Tsakiris98/Plug-Roll---Digital-Audio-Multi-Effect-Device/docs/input-section.md

# Input Section — Design Note (v0.5, 2026-11-12)

Status: **architecture and parts approved; schematic in progress** (drawn so
far: input jacks, INST/LINE relays, LINE receivers, INST buffer, gain stages
and ADC pad; the input section is complete except for the Daisy Seed socket). Every number marked
*(measure)* is provisional until it is measured on the real Daisy Seed Rev 5.

Changes from v0.4 (decision of 2026-11-12): **no digital control of analog
switching.** The INST/LINE toggle switches the relay coils directly; the
transistor driver and the three Daisy pins of this section (toggle, relays,
Right jack detection) are removed (sections 6 and 8).

Approved on 2026-11-12: output pad 5.6 kΩ / 1 kΩ; INST/LINE relays; analog pots on the control board with shielded analog cables; mono
normalling at the Right receiver input with the Neutrik NMJ6HCD2 jack.

Changes from v0.3: parts selected and checked at JLCPCB (section 10); SMD
wherever a part exists in SMD, including the relays; receiver built from one
0.1 % resistor value (gain exactly ×0.5); fixed gain ×11 with Basic resistor
values (was ×12 with an Extended 11 kΩ); numbers in sections 4 and 5
recalculated.

Changes from v0.2: relays are driven by the Daisy, the toggle goes only to a
GPIO, power-on default state added (section 6); jack contacts confirmed on the
Neutrik drawing (section 8); first-board acceptance measurements added
(section 11).

## 1. What the Daisy Seed Rev 5 gives us

| Item | Value | Source |
|---|---|---|
| Codec | WM8731 | Daisy Seed datasheet v1.0.5, schematic 4 of 4 |
| Audio pins used | 16 = Audio In L, 17 = Audio In R, 18 = Audio Out L, 19 = Audio Out R, 20 = AGND. The Seed's own codec is the only converter; nothing is added to it. | Daisy Seed datasheet v1.0.5, pin table |
| Circuit between the audio input pin and the codec | 0 Ω series, 2.2 µF coupling capacitor, nothing else (shunt capacitor not fitted) | same schematic (R24/C33, R26/C34) |
| ADC full scale | 1.0 Vrms × AVDD/3.3 (1.41 V peak at 3.3 V) | WM8731 datasheet, "Line Input to ADC" |
| Seed datasheet statement | "AC coupled and 3.6 Vpp, or approx. 1 Vrms" | Daisy Seed datasheet v1.0.5, p. 5 |
| Absolute maximum at the Seed audio input pins | −1.8 V … +1.8 V | Daisy Seed datasheet v1.0.5, Table 1 |
| Codec pin absolute maximum | AGND − 0.3 V … AVDD + 0.3 V | WM8731 datasheet, absolute maximum ratings |
| Codec input bias point | VMID = AVDD/2 = 1.65 V | WM8731 datasheet |
| Input resistance | 20 kΩ min, 30 kΩ typ (0 dB gain) | WM8731 datasheet |
| ADC SNR | 85 dB min, 90 dB typ, A-weighted, 48 kHz | WM8731 datasheet |

What this means:

- **The pins take a plain AC audio signal.** The coupling capacitor and the
  codec's bias are on the Seed. Our board adds no bias and no converter: the
  whole input section only brings each source to the right level for pins 16
  and 17, and the output section does the same from pins 18 and 19.
- **The Seed adds no protection of its own.** The pin goes through 0 Ω and a
  capacitor straight to the codec. Whatever limits the voltage and the current
  must be on our board.
- **Where ±1.8 V comes from.** The codec pin rests at 1.65 V. ±1.8 V around
  that is −0.15 V … +3.45 V, just inside the codec's own limit of −0.3 V …
  +3.6 V. The codec limit itself corresponds to ±1.95 V at the Seed pin.
- **The Seed datasheet contradicts itself.** 3.6 Vpp is 1.27 Vrms, not 1 Vrms.
  The codec datasheet says 1.0 Vrms, and "3.6 Vpp" looks like the ±1.8 V
  limit, not the full scale. This note assumes **0 dBFS = 1.0 Vrms = +2.2 dBu
  = 1.41 V peak** at the pin *(measure)*.
- **The limit is only 2.1 dB above full scale** (1.8 V against 1.41 V).

## 2. Block diagram

```
                      K1 (relay)
 L jack tip ─ RF ─────┬─ LINE ──────► LINE receiver L (balanced, −6.0 dB) ──┐
 L jack ring ─ RF ────│─────────────►                                       ├─ K2a ─► L chain
                      └─ INST ──────► INST buffer (1 MΩ, +12 dB) ───┬───────┘
                                      + diode clamp                 │
                                                                    │
 R jack tip ─ RF ───────────────────► LINE receiver R (balanced, −6.0 dB) ──┐
 R jack ring ─ RF ──────────────────►                               │       ├─ K2b ─► R chain
   (R jack empty: its switch contacts connect the R receiver        └───────┘
    inputs to the L receiver inputs)

 L chain / R chain (identical):

   ─► shielded cable ─► GAIN pot on the control board (one gang) ─► shielded cable ─►
      fixed gain +20.8 dB ──●── output pad −16.6 dB ── RC ──► Daisy ADC
                            │
                       "hot node" ──► bypass tap (to the output section)
```

- K1, K2a, K2b are relay contacts, switched together by the panel toggle (section 6).
  In INST, both chains take the INST buffer.
- "Hot node" = output of the last op-amp. 0 dBFS at the ADC corresponds to
  +18.9 dBu (9.6 V peak) there.

## 3. Output pad: keep the signal big, attenuate at the very end

**What it does.** The analog chain works at a high level (several volts). A
resistor divider ("pad") directly in front of the Daisy pin brings it down to
codec level. Values: **5.6 kΩ in series, 1 kΩ to ground**, with 2.2 nF C0G
across the 1 kΩ (low-pass at about 88 kHz against RF and out-of-band noise).

**Why.**
1. *Voltage limit by construction.* The op-amp output cannot go beyond its
   supply rails, so the pin cannot go beyond rail × divider ratio.
2. *Current limit by construction.* All current into the Seed passes through
   the 5.6 kΩ.
3. *Noise.* Op-amp noise is attenuated together with the signal.
4. *Bypass and output levels match.* 0 dBFS at the hot node is +18.9 dBu. The
   requirements ask for about +18 dBu maximum output. The output stage needs
   about +16.6 dB after the DAC anyway, and then the bypass signal taken at
   the hot node has the same level as the DAC path.

**Alternative and its cost.** Run the chain at codec level and clamp the pin
with Schottky diodes. Costs: diodes that protect at 1.8 V already conduct
below 1.41 V (distortion on peaks); BAT54S is an Extended part; the bypass
needs about 16 dB make-up gain; op-amp noise is not attenuated.

### 3.1 Check against the datasheets (your question)

What the NE5532 datasheet says about maximum output:

- The current TI datasheet (SLOS075K, December 2025) gives **no output swing
  figure at all**. Its revision history says the row "Maximum peak-to-peak
  output voltage swing" was removed.
- The previous revision (SLOS075J, 2015) gave 24 V min, 26 V typ peak-to-peak
  on ±15 V with a load of 600 Ω or more: the output stops 2 V (typical) to 3 V
  (worst case) short of each rail. That is a guarantee of how far the output
  *reaches*, not of where it *stops*.
- So the only upper limit a datasheet can prove is the supply rail itself.
  Recommended supply is ±5 V to ±15 V, so ±12 V is inside the specified range.

Divider ratio: unloaded 1/6.6 = 0.1515; with the codec's 30 kΩ typ 0.1473
(−16.6 dB); with its 20 kΩ min 0.1453. I assume the ±12 V rails stay within
±5 % (11.4 … 12.6 V). This becomes a requirement for the power supply.

| Op-amp output at | Hot node | Pin, Seed fitted (30 kΩ) | Pin, worst case (unloaded ratio) |
|---|---|---|---|
| Full scale, 0 dBFS | 9.6 V | 1.41 V | |
| Typical swing, nominal rail (12 V − 2 V) | 10.0 V | 1.47 V | 1.52 V |
| Typical swing, rail +5 % (12.6 V − 2 V) | 10.6 V | 1.56 V | 1.61 V |
| 1 V below a +5 % rail (more than the part can do) | 11.6 V | 1.71 V | 1.76 V |
| **Exactly on a +5 % rail (physically impossible)** | 12.6 V | **1.86 V** | **1.91 V** |

**Answer.** In every condition the op-amp can really reach, the pin stays at
or below 1.76 V, inside ±1.8 V. A proof that needs nothing but the datasheet
has to assume the output sits exactly on the rail, and then the pin could be
0.06 to 0.11 V over the Seed limit, still below the codec's own limit
(1.95 V). The real swing and the real pin voltage are measured on the first
board **before the Seed is plugged in** (section 11).

**Current limit.** Seen from the Seed pin, the pad is a voltage source of at
most 1.91 V behind 850 Ω (5.6 kΩ in parallel with 1 kΩ).

| Situation | Current into the Seed pin |
|---|---|
| Normal, full scale | 47 µA peak (1.41 V into 30 kΩ) |
| Pin tries to go over 1.8 V and the codec clamps it there | at most (1.91 − 1.8) V / 850 Ω = **0.13 mA** |
| Any fault at all (pin shorted, Seed unpowered while ±12 V is on) | at most 12.6 V / 5.6 kΩ = **2.3 mA** |

The WM8731 datasheet gives no rating for current forced into an input, so I
cannot quote a guaranteed safe value. Fractions of a milliamp through 5.6 kΩ
are far below what normally harms a CMOS input, and the 2.2 µF capacitor on
the Seed blocks any DC.

**The trade-off in the pad value.**

| Series resistor | Pin if the output were on a +5 % rail | Op-amp level needed for 0 dBFS | Consequence |
|---|---|---|---|
| 5.1 kΩ | 2.01 – 2.07 V | 8.9 V peak | ADC always reaches full scale; larger theoretical excess |
| **5.6 kΩ (chosen)** | 1.86 – 1.91 V | 9.6 V peak | full scale with a typical op-amp; a weak one clips about 0.5 dB earlier |
| 6.2 kΩ | 1.70 – 1.75 V | 10.5 V peak | provably inside ±1.8 V; the op-amp clips 0.4 – 1.9 dB before the ADC, so the last LEDs of the meter would never light |

**Approved: 5.6 kΩ / 1 kΩ.** It is one resistor per channel, so it can still
change to 5.1 kΩ or 6.2 kΩ if the measurements on the first board ask for it.

## 4. Gain staging

Reference: 0 dBFS = +2.2 dBu at the pin = +18.9 dBu at the hot node.
Target −18 dBFS = +0.9 dBu at the hot node.

| Stage | Gain | Resistors (provisional) |
|---|---|---|
| LINE receiver | −6.0 dB (×0.5) | differential amplifier, 10 kΩ inputs, 5 kΩ feedback made of two 10 kΩ in parallel (all 0.1 %) |
| INST buffer | +12 dB (×4) | non-inverting, 3 kΩ / 1 kΩ, 1 MΩ to ground at the input |
| GAIN pot | −∞ … 0 dB | 10 kΩ dual-gang audio taper, used as a divider |
| Fixed gain | +20.8 dB (×11) | non-inverting, 10 kΩ / 1 kΩ |
| Output pad | −16.6 dB | 5.6 kΩ / 1 kΩ (with the 30 kΩ of the codec) |

Total range, input jack to hot node: LINE −∞ … +14.8 dB, INST −∞ … +32.9 dB.

| Source | Input level | Total gain needed | Pot setting | ADC level | Notes |
|---|---|---|---|---|---|
| LINE, studio nominal | +4 dBu | −3.1 dB | −18.0 dB | −18 dBFS | around mid rotation of an audio-taper pot |
| LINE, hot peaks | +20 dBu | same | same | −2 dBFS | 2 dB spare without touching the knob |
| LINE, consumer | −10 dBV (−7.8 dBu) | +8.7 dB | −6.2 dB | −18 dBFS | |
| LINE, max before the receiver clips | about +24 dBu | | | | assumes ±9 V swing *(measure)* |
| INST, average guitar *(typical, measure)* | about −18 dBu | +18.9 dB | −14.0 dB | −18 dBFS | |
| INST, weak single coil *(typical)* | about −30 dBu | +30.9 dB | −2.0 dB | −18 dBFS | |
| INST, max before the buffer clips | about 2.3 V peak (+6 dBu) | | | | hot active pickups may exceed this |

Decisions:

- **LINE receiver attenuates by 6 dB.** A +20 dBu signal is 11 V peak, more
  than an op-amp on ±12 V can pass at unity gain. The receiver's resistors
  halve it before the op-amp sees it. Cost: 6 dB of gain made up later, which
  is harmless here (section 5).
- **Gain pot as a passive divider, followed by a fixed gain stage.** Simple,
  can always be turned down to silence, and almost no DC flows through the
  wiper. Alternative: pot in the feedback loop of an op-amp. Less noise at low
  gain, but it cannot go below unity, has an awkward control law, and a remote
  pot inside a feedback loop is asking for instability.
- **Resistor values follow what is Basic at JLCPCB.** ×11 uses 10 kΩ and
  1 kΩ, both Basic and already in the design; 11 kΩ (for ×12) is Extended.
  The receiver uses a single 0.1 % value (10 kΩ): two in parallel make the
  5 kΩ, so only one Extended resistor type is needed and the gain is exactly
  one half.
- **INST buffer has +12 dB.** A guitar is 15–20 dB quieter than line level.
  Gain in the first stage puts both modes in the same range of the knob. Cost:
  inputs above about 2.3 V peak clip in the buffer. Synths and keyboards on TS
  cables belong in LINE mode. If your guitars are hotter, this becomes +6 dB
  (one resistor).
- **Two 100 pF capacitors per gain stage, added when the schematic was
  drawn.** One across the 10 kΩ feedback resistor: it limits the bandwidth of
  the ×11 stage to about 160 kHz (−0.07 dB at 20 kHz), which keeps the stage
  stable and stops it amplifying radio frequencies. One from the wiper input
  to ground, next to the 100 kΩ: the wiper arrives through a cable, and this
  shorts any radio frequency the cable picks up (corner above 600 kHz with
  the 2.5 kΩ of the pot).
- **Known risk: pot rustle.** The NE5532 input draws a small DC current
  (200 nA typ, 800 nA max, TI SLOS075K) through the wiper. With some pots this
  is heard as a faint rustle while the knob is turned. It also gives a DC
  offset at the hot node that changes with the knob (at most about 22 mV from
  this current, plus the op-amp's own offset times 11). Checked on the
  prototype *(measure)*. Fallback without a board change: fit a TL072 in the
  U3 position (same SOIC-8 pinout, picoamp input current); the cost is more
  hiss at high gain, still below the codec floor.
- **The two gangs of an audio-taper pot do not track perfectly** (a few dB
  left/right error at low settings is normal for the part).

## 5. Noise estimate (20 Hz – 20 kHz, unweighted, calculated)

Op-amp data: NE5532 5 nV/√Hz and 0.7 pA/√Hz at 1 kHz (TI SLOS075K); TL072
15 nV/√Hz (value listed by JLCPCB for the ST part). Resistor thermal noise at
25 °C.

| Case | Noise at the hot node | Relative to full scale |
|---|---|---|
| LINE, pot at nominal (+4 dBu → −18 dBFS) | 15 µV (−94.4 dBu) | **−113 dBFS** |
| LINE, pot at maximum | 30 µV (−88.3 dBu) | **−107 dBFS** |
| INST, pot at "average guitar", input shorted | 24 µV (−90.0 dBu) | **−109 dBFS** |
| INST, pot at maximum (+32.9 dB), input shorted | 99 µV (−77.8 dBu) | **−97 dBFS** |
| Output pad resistors alone | 0.5 µV at the pin | −126 dBFS |
| **WM8731 ADC (datasheet, A-weighted)** | | **−90 dBFS typ, −85 dBFS min** |

Equivalent input noise: LINE receiver about −104 dBu, INST buffer about
−111 dBu (input shorted; a real pickup adds thermal noise of the same order).

**Conclusion.** In every setting the analog chain is 7 to 23 dB quieter than
the codec's typical figure. The noise floor of this device is the WM8731. The
only way to use it well is level: nominal −18 dBFS leaves about 70 dB between
the signal and the codec floor. A more expensive op-amp would change nothing
audible. Not included in the calculation: hum picked up by the pot cable
(section 7) and the real Rev 5 floor, which forum reports say is worse than
the datasheet. Both are measured.

## 6. INST/LINE switching (relays switched by the panel toggle)

**Contacts.** Three changeover contacts, switched together:

- K1: L jack tip goes to the LINE receiver (LINE) or to the INST buffer
  (INST). Without it, the 15 kΩ of the receiver would load the guitar and the
  1 MΩ input would be lost.
- K2a: the L chain takes the L receiver (LINE) or the INST buffer (INST).
- K2b: the R chain takes the R receiver (LINE) or the INST buffer (INST).
  **In INST the right channel always gets the left signal, whatever is plugged
  into the Right jack.**

Two 2-pole signal relays cover this, with one contact spare: **Omron
G6K-2F-Y-5V** (SMD, 10 × 6.5 mm, 5 V coil, 237 Ω, about 21 mA each). Contacts
are silver with gold cladding, rated down to 10 µA at 10 mV (Omron
datasheet), operate and release time 3 ms max. Gold-clad contacts are what a
small audio signal needs: plain silver contacts tarnish and need real current
to break through the film. The same relay is proposed for the bypass relay,
so one part number.

Relay pins, from the Omron G6K datasheet ("Terminal Arrangement/Internal
Connections", top view, G6K-2F-Y): 1 = coil +, 8 = coil −; moving contacts 3
and 6; released they rest on 2 and 7, energised they switch to 4 and 5. Coil
5 VDC: 21.1 mA, 237 Ω, must operate at 80 % of rated voltage or less, must
release at 10 % or more. The coil is polarised: pin 1 goes to +5 V.

| Contact | Moving (pin) | Released = LINE (pin) | Energised = INST (pin) |
|---|---|---|---|
| K1, first set | Left jack tip (3) | L receiver hot input (2) | INST buffer input (4) |
| K1, second set | not used (6) | (7) | (5) |
| K2, first set | L chain input (3) | L receiver output (2) | INST buffer output (4) |
| K2, second set | R chain input (6) | R receiver output (7) | INST buffer output (5) |

A 100 nF capacitor sits on the 5 V rail at the relays.

One caution: at K1 the guitar signal flows into 1 MΩ, which is well below
10 µA. Gold contacts normally handle this, but it is outside the datasheet
figure, so it is on the list of things to listen for on the prototype.

**Control.**

- The panel toggle switches the two relay coils directly. Coil + (pin 1) is
  on the 5 V rail of the main board. Coil − (pin 8) of both relays is the line
  `INST_SW`, which goes through the ribbon to the toggle on the control
  board; the toggle closes it to ground. **Open = LINE, closed = INST.**
- A 1N4148W diode across the coils absorbs the voltage spike when the toggle
  opens. A 100 nF capacitor sits on the 5 V rail at the relays.
- The ribbon wire carries about 42 mA DC in INST mode and nothing in LINE.
  It is a steady current, so it does not disturb the control voltages next
  to it; it only steps when the toggle is moved.
- **No Daisy pin, no firmware.** The Daisy does not know the mode and does
  not need to: in INST the right chain already gets the left signal through
  K2, in the analog path.
- Why relays at all, when a toggle could switch the signal itself: the toggle
  is on the control board. Switching the audio there would send the
  high-impedance guitar signal through a cable to the panel and back, which
  picks up hum and loses treble. The relays keep the signal at the jacks and
  only the coil current travels.

**Power-on.** The relays follow the toggle as soon as 5 V is present. The
outputs are muted during power-up and power-down (output section), so this is
not heard. With the control board unplugged the relays stay released = LINE,
the safe state (LINE accepts up to about +24 dBu).

**Click without a firmware mute.** Until v0.4 the Daisy drove the relays, so
the firmware could mute, switch and unmute. Without that, a click would come
from the two sources of a relay contact (LINE receiver and INST buffer
outputs) sitting at slightly different DC voltages, a step that the ×11 stage
amplifies. Therefore each of the three sources reaches K2 through a coupling
capacitor (10 µF, 50 V) with 100 kΩ to ground on the relay side: both sides
of every contact rest at 0 V. This also takes the sources' DC offset off the
gain pot. Low corner with the 10 kΩ pot: 1.6 Hz (3.2 Hz in INST, where one
capacitor feeds both pot sections). Residual click measured on the prototype
(section 11.2); the fallback is the transistor driver with a firmware mute.

GPIOs used by the input section: **none.**

## 7. Analog pots on the control board (decided)

All pots stay on the control board. The pre-amp gain pot gets a **dedicated
short shielded analog connection**, separate from the digital ribbon. The same
rule applies to master volume and HP volume (output section).

What matters for the gain pot, and why:

- **Its ground is the main board's analog ground, brought over in the same
  cable.** The bottom end of the pot is the reference of the following ×11
  stage. If it were tied to the control board's ground, every millivolt of LED
  and scanning current noise between the two boards would be amplified 11
  times. The pot must not touch the control board ground at all.
- **Input and output pots do not share a cable.** The wiper of the gain pot
  is a sensitive point followed by ×11. If it ran next to the master volume
  wires (the output of the same device), the output would leak back into the
  input: a feedback path around the whole effect chain. So: one shielded cable
  for the gain pot, a separate one for master + HP volume, connectors apart.
- **Each wiper wire is shielded**, shield connected at the main board only.
  The wiper is the only point in the chain with a few kΩ of impedance
  (2.5 kΩ at worst); everything else is driven by op-amp outputs.
- **A 100 kΩ resistor from the wiper input to ground on the main board**, so
  the stage stays quiet if the cable is unplugged.
- **Connection (approved):** these are *internal* connectors between the two
  boards, not panel jacks. One 3.5 mm stereo jack per
  channel on each board (SMD, PJ-327A) and a ready-made shielded 3.5 mm
  stereo cable between them, 15–20 cm. Tip = top of the pot, ring = wiper,
  sleeve = analog ground and shield. Why: these cables are shielded, cheap,
  available in any length, and need no crimping tool. One cable per channel
  also keeps left and right apart. Alternative: JST-type headers with a
  hand-made shielded cable; smaller, but you would have to crimp the contacts
  and prepare the shield yourself.
- **PJ-327A 5JJ pins, from the SHOU HAN drawing (2020.6.24):** pins 1 and 2 =
  sleeve, pin 3 = ring, pin 4 = tip, pin 5 = switch contact that rests on the
  tip while no plug is inserted. Use: pin 4 = top of the pot, pin 3 = wiper,
  pins 1 and 2 = analog ground. **Pin 5 stays unconnected**: grounding it
  would short the driving op-amp whenever the cable is unplugged.
- 100 Ω in series with the "top" line on the main board. It keeps the cable
  capacitance away from the op-amp output and limits the current when a plug
  is pushed in (its tip slides over the other contacts on the way).

Everything that is not audio goes in the general ribbon cable: LEDs, buttons,
encoder, INST/LINE toggle, and the 40 control pots with their multiplexers
(they only carry a control voltage that the Daisy reads). Master and HP
volume carry audio like the gain pot, so they stay out of the general ribbon;
their cable is decided in the output section.

Cost of this decision against a pot on the main board: one more cable and two
connectors, and some risk of hum pickup that only the prototype can quantify.

## 8. Mono normalling and jack (approved)

**Jack.** Neutrik NMJ6HCD2, 6.35 mm TRS, horizontal PCB mount, through-hole.
LCSC **C368502**, 772 in stock on 2026-11-12. Used for both inputs
(hand-soldered).

**Two separate jacks, one per channel: Left and Right.** Neutrik calls the
part "stereo" only because it has three conductors. Here each jack carries
one balanced mono channel: tip = hot (+), ring = cold (−), sleeve = ground.
A TS plug also works (the ring is then grounded by the plug).

**Contact arrangement, confirmed from Neutrik.**

- Drawing ST-NMJ6HCD2 (released 26.02.2021): six PCB pins in two rows
  16.23 mm apart. One row is **T, R, S**, the other **TN, RN, SN**, at 16.7,
  10.35 and 4 mm from the panel face. Hole diameter 1.4 mm, panel cut-out
  11.4 mm.
- Neutrik "Jacks – Circuits" list: type N\*J6\*\* is "3x switching
  (normalling) Stereo". Each of TN, RN, SN rests on its own T, R, S spring
  while the jack is empty and opens when a plug is inserted.
- Switch contact rating: 0.5 A at 50 V (Neutrik product page). Far above what
  a line signal or a logic input needs.

These are *normalling* contacts, not an isolated switch: a contact can only
feed something into the jack's own terminals, that is, into the input of the
Right receiver. That is why the normalling is done at the receiver input.

**Implementation.**

- R jack **TN** → L receiver hot input (taken after K1); R jack **RN** → L
  receiver cold input. With the Right jack empty, both receivers listen to the
  Left jack. The right channel then carries the left signal for the DSP and
  for the analog bypass, at the same level.
- L jack TN and RN → ground, so an empty Left input is silent.
- SN of both jacks is not used. The Daisy needs no mono detection: the
  normalling already puts the left signal on both channels.
- No relay, no extra parts. The source sees two receivers in parallel (about
  10 kΩ balanced), which any line output drives without effort.
- In INST the normalling does not matter: K2b gives the right chain the INST
  buffer. Because the R jack's TN is wired after K1, the Right receiver does
  not load the guitar either.

## 9. Input protection

- **LINE inputs.** The receiver's own 10 kΩ input resistors limit the current.
  A BAV99 at each op-amp input steers anything beyond the ±12 V rails into the
  supply. DC-blocking capacitors in front (10 µF, 50 V, 1.6 Hz corner) stop
  DC from a faulty source. 100 pF C0G from each leg to ground at the jack
  shorts radio frequencies.
- **DC-blocking capacitor type.** 10 µF / 50 V ceramic (X5R, 1206, Basic).
  This kind of ceramic changes its capacitance a little with the voltage
  across it, which can distort. Here it does not matter, because almost no
  signal voltage appears across a capacitor this large: about 5 % of the
  signal at 20 Hz, falling quickly above that. The large value is also what
  keeps the hum rejection good at 50 Hz (the two capacitors of a receiver are
  not identical). Alternative: bipolar electrolytic capacitors, the classic
  audio choice, but through-hole and hand-soldered. Low-frequency distortion
  is checked on the prototype *(measure)*. 1206 is an exception to the 0603
  rule: 10 µF at 50 V does not exist in 0603.
- **INST input.** 1 kΩ series resistor, 100 pF to ground, 100 nF (X7R, 50 V)
  blocking capacitor into 1 MΩ (1.6 Hz corner), BAV99 to the rails directly at
  the op-amp input. The clamp sits after the capacitor on purpose: a voltage
  step at the jack passes through the capacitor unchanged, so a clamp in front
  of it would not protect the op-amp input. The capacitor itself is rated
  50 V. Cost: the leakage current of the diodes flows through the 1 MΩ and
  adds a small DC offset at the buffer output *(measure)*. The 1 kΩ is a
  compromise: larger protects better but adds hiss (1 kΩ adds 4 nV/√Hz against
  the 15 nV/√Hz of the op-amp).
- **Daisy pin.** Protected by the pad (section 3). No diodes.
- **Receiver precision.** A balanced receiver rejects hum only as well as its
  resistors match: about 30 dB with 1 % parts, about 50 dB with 0.1 %. All
  receiver resistors are 10 kΩ 0.1 % thin film (six per receiver, twelve in
  total). Extended part, justified: hum rejection depends on it.

## 10. Parts

Basic/Extended status and stock read from jlcpcb.com on 2026-11-12. Every part
below has a symbol, footprint and 3D model in the LCSC/EasyEDA library
(checked with easyeda2kicad). **Rule: SMD wherever the part exists in SMD;**
through-hole only for the panel jacks.

### 10.1 Placed by JLCPCB (SMD)

| Function | Part | Package | LCSC | Library | JLCPCB stock | Qty |
|---|---|---|---|---|---|---|
| Op-amp: receivers, gain stages | NE5532DR, TI | SOIC-8 | C7426 | Basic | 265,940 | 2 |
| Op-amp: INST buffer | TL072CDT, ST | SO-8 | C6961 | Basic | 123,888 | 1 |
| Clamp diodes | BAV99,215, Nexperia | SOT-23 | C2500 | Basic | 1,914,133 | 5 |
| INST/LINE relays | G6K-2F-Y-5V, Omron | SMD 10 × 6.5 mm | C2982926 | **Extended** | 29,764 | 2 |
| Relay coil diode | 1N4148W | SOD-123 | C81598 | Basic | 3,368,367 | 1 |
| Receiver resistors 10 kΩ 0.1 % thin film | RT0603BRD0710KL, Yageo | 0603 | C95204 | **Extended** | 1,769,696 | 12 |
| Resistor 100 Ω 1 % | 0603WAF1000T5E | 0603 | C22775 | Basic | 9,914,941 | |
| Resistor 1 kΩ 1 % | 0603WAF1001T5E | 0603 | C21190 | Basic | 28,867,822 | |
| Resistor 3 kΩ 1 % | 0603WAF3001T5E | 0603 | C4211 | Basic | 6,321,740 | |
| Resistor 5.6 kΩ 1 % (pad) | 0603WAF5601T5E | 0603 | C23189 | Basic | 666,557 | 2 |
| Resistor 10 kΩ 1 % | 0603WAF1002T5E | 0603 | C25804 | Basic | 42,786,584 | |
| Resistor 100 kΩ 1 % | 0603WAF1003T5E | 0603 | C25803 | Basic | 15,036,949 | |
| Resistor 1 MΩ 1 % | 0603WAF1004T5E | 0603 | C22935 | Basic | 3,882,525 | |
| Capacitor 100 pF C0G 50 V (RF, feedback) | CL10C101JB8NNNC, Samsung | 0603 | C14858 | Basic | 3,542,892 | |
| Capacitor 2.2 nF C0G 50 V (pad filter) | 0603CG222J500NT, FH | 0603 | C2991172 | **Extended** | 68,303 | 2 |
| Capacitor 100 nF X7R 50 V (decoupling, INST coupling) | CC0603KRX7R9BB104, Yageo | 0603 | C14663 | Basic | 36,013,175 | |
| Capacitor 10 µF X5R 50 V (LINE DC blocking, supply bulk) | CL31A106KBHNNNE, Samsung | 1206 | C13585 | Basic | 3,429,083 | |
| Gain pot cable jack 3.5 mm stereo | PJ-327A 5JJ, SHOU HAN | SMD | C668605 | **Extended** | 10,744 | 2 |

Quantities without a number are fixed when the schematic is drawn.

Four Extended part types in this section (relay, 0.1 % resistor, C0G 2.2 nF,
3.5 mm jack). Each has a one-time fee of about 3 USD per order at JLCPCB. All
four are there for a reason that affects the audio or has no Basic
equivalent:

- 2.2 nF **C0G** at the ADC pin: the Basic 2.2 nF is X7R, a ceramic that
  distorts when the full signal sits across it. C0G does not.
- Relay and 3.5 mm jack: no Basic part of this kind exists.

### 10.2 Hand-soldered (through-hole)

| Function | Part | LCSC | Stock (LCSC) | Qty |
|---|---|---|---|---|
| Input jacks L and R | NMJ6HCD2, Neutrik | C368502 | 772 | 2 |

### 10.3 Alternatives for critical parts

| Part | Alternative | LCSC | Library | JLCPCB stock | Note |
|---|---|---|---|---|---|
| G6K-2F-Y-5V | HFD4/5-SR, Hongfa | C64399 | Extended | 29,205 | same body size and coil voltage, 28 mA coil; its own footprint, not drop-in |
| TL072CDT | TL072CDR, TI | C67473 | Extended | 49,480 | same pinout |
| NE5532DR | NE5532DTR, XBLW | C18723604 | Extended | 1,109 | weak alternative (low stock); the TI part has 265,940 in stock |
| 2.2 nF C0G | GRM1885C1H222JA01D, Murata | C77033 | Extended | 44,811 | same value and size |

### 10.4 Why two op-amp types

The NE5532 has bipolar inputs that draw 200 nA typ, 800 nA max (TI
SLOS075K). Through the 1 MΩ a guitar input needs, that is 0.2 to 0.8 V of DC
offset, and its current noise through a high-impedance pickup would hiss. The
TL072 draws picoamps, so it is the right part for the one high-impedance
node. Everywhere else impedances are low and the NE5532 is about 10 dB
quieter. Both are Basic, so the second type costs no fee. Alternative: one
FET-input audio op-amp everywhere (OPA1678 class): Extended, and section 5
shows it would not be audible.

Count: 2× NE5532 (L/R receivers, L/R gain stages) + 1× TL072 (INST buffer, one
half spare and tied off).

### 10.5 Not part of the main board

Chosen with the control board: the gain pot itself (10 kΩ dual-gang, audio
taper), the INST/LINE toggle, and the 3.5 mm jacks on the control board side.
The two 3.5 mm cables are bought ready-made.

## 11. To be measured

### 11.1 First-board acceptance test (required, before the Seed is plugged in)

Done on the assembled main board with the Daisy Seed **not fitted**. Without
the Seed the pad is unloaded, which is the highest voltage the pin can ever
see, so the test is safe and worst-case at the same time.

| Step | Measurement | Pass condition |
|---|---|---|
| 1 | +12 V and −12 V rails with a multimeter | each within 11.4 … 12.6 V |
| 2 | Drive each channel hard into clipping (1 kHz sine, gain at maximum). Oscilloscope on the hot node: positive and negative peak | record both values: this is the real swing of the NE5532 |
| 3 | Same signal, oscilloscope on the Daisy audio input pin of the socket: positive and negative peak | **both inside ±1.8 V** |
| 4 | Switch power on and off several times with the scope on the same pin (single-shot trigger) | no excursion beyond ±1.8 V |

Then fit the Seed and repeat step 3 once. The loaded value must be lower than
the unloaded one. If step 3 or 4 fails, the series resistor goes to 6.2 kΩ
before the Seed is ever fitted. The measured values are written into this
note.

### 11.2 Other measurements

| What | How | Decides |
|---|---|---|
| ADC full scale of this Rev 5 Seed | sine of known Vrms into the pin, read dBFS in firmware | pad ratio |
| Input resistance of the Seed pin | level drop through a known series resistor | pad ratio |
| ADC noise floor | input shorted through 850 Ω, read RMS in firmware | real dynamic range |
| DAC full scale and noise | firmware sine out, measure Vrms | output section gain |
| Hum and noise with the pot cable fitted | input shorted, gain at maximum | cable routing and shielding |
| Click when switching INST/LINE with the gain up | scope on the hot node and listening | whether a coupling capacitor after K2 or a Daisy-driven mute is needed |
| K1 relay contact with a guitar (very small current) | listening for crackle or dropouts over time | relay type at the INST input |
| Distortion at 20–50 Hz through the LINE input capacitors | THD measurement at +20 dBu | ceramic or bipolar electrolytic |
| Rustle while turning the gain pot, DC at the hot node against pot position | listening at high monitor level, multimeter on the hot node | NE5532 or TL072 in the gain stage (U3) |
| Level of your instruments | guitar/synth into a scope or interface | INST buffer gain (+12 or +6 dB) |

## Sources

- Daisy Seed datasheet v1.0.5 (Electrosmith): Table 1, p. 5; Fig. 1.2; schematic 4 of 4.
- WM8731 / WM8731L datasheet (Wolfson, Production Data rev 3.4): absolute maximum ratings, "Line Input to ADC", Figure 11.
- NE5532 datasheet, TI SLOS075K (December 2025): sections 5.1, 5.3, 5.5, 5.6 and revision history. Output swing figures of SLOS075J (2015) as quoted by TI's document viewer.
- Electrosmith forum: "Rev5 seed producing ~13dB higher noise floor".
- SHOU HAN: drawing PJ-327A 5JJ (LCSC datasheet for C668605).
- Neutrik: drawing ST-NMJ6HCD2, "Jacks – Circuits" list (2015/09/15), product page NMJ6HCD2.
- JLCPCB part pages of every LCSC number in section 10; LCSC product page C368502.
- Omron G6K datasheet (omronfs.omron.com, en-g6k.pdf): coil ratings, characteristics, contact data, terminal arrangement of G6K-2F-Y.
