Tsakiris98/Plug-Roll---Digital-Audio-Multi-Effect-Device/hardware/main-board/export/main-board-schematic.pdf

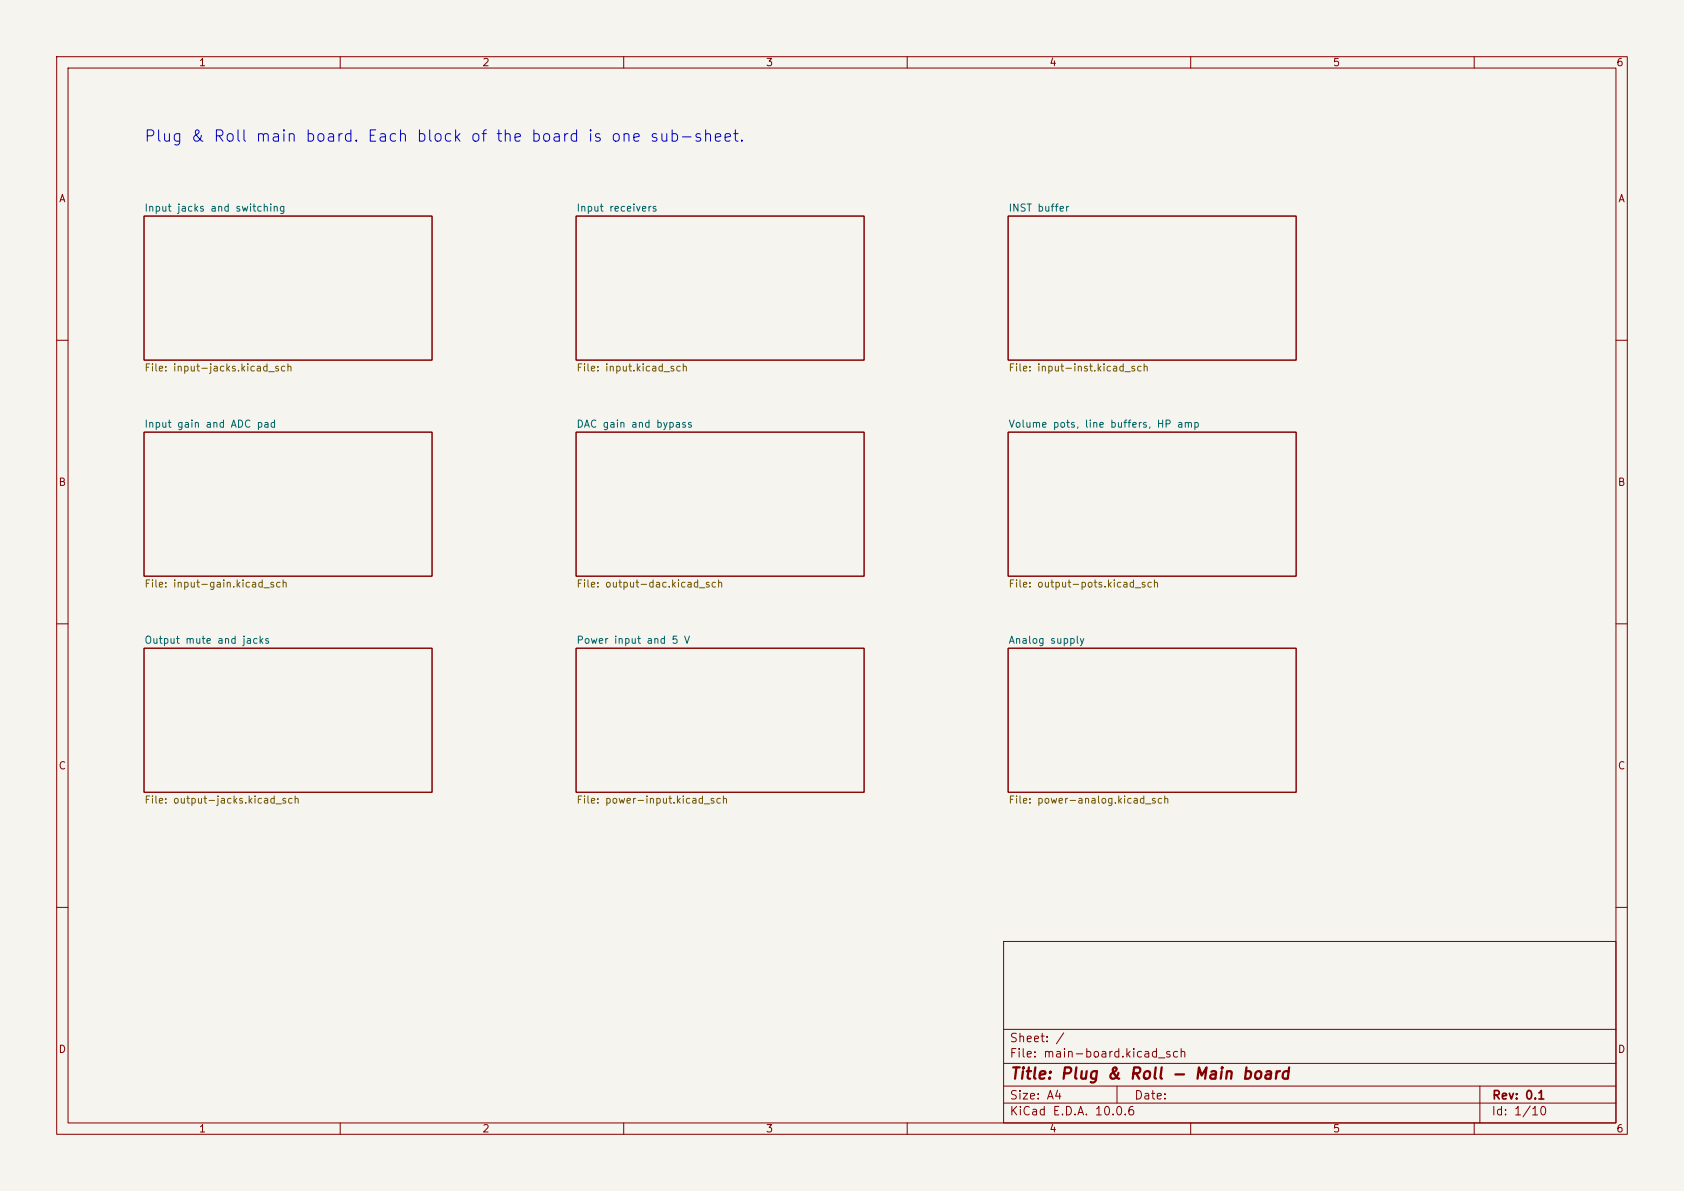
[picture p1: page 1]

Plug & Roll main board. Each block of the board is one sub-sheet.

Input jacks and switching

Input receivers File: input.kicad_sch

INST buffer File: input-inst.kicad_sch DAC gain and bypass File: output-dac.kicad_sch

Input gain and ADC pad

Volume pots, line buffers, HP amp

Analog supply File: power-analog.kicad_sch

Sheet: /
File: main-board.kicad_sch
Title: Plug & Roll - Main board

Size: A4 | Rev: 0.1
KiCad E.D.A. 10.0.6 | Id: 1/10

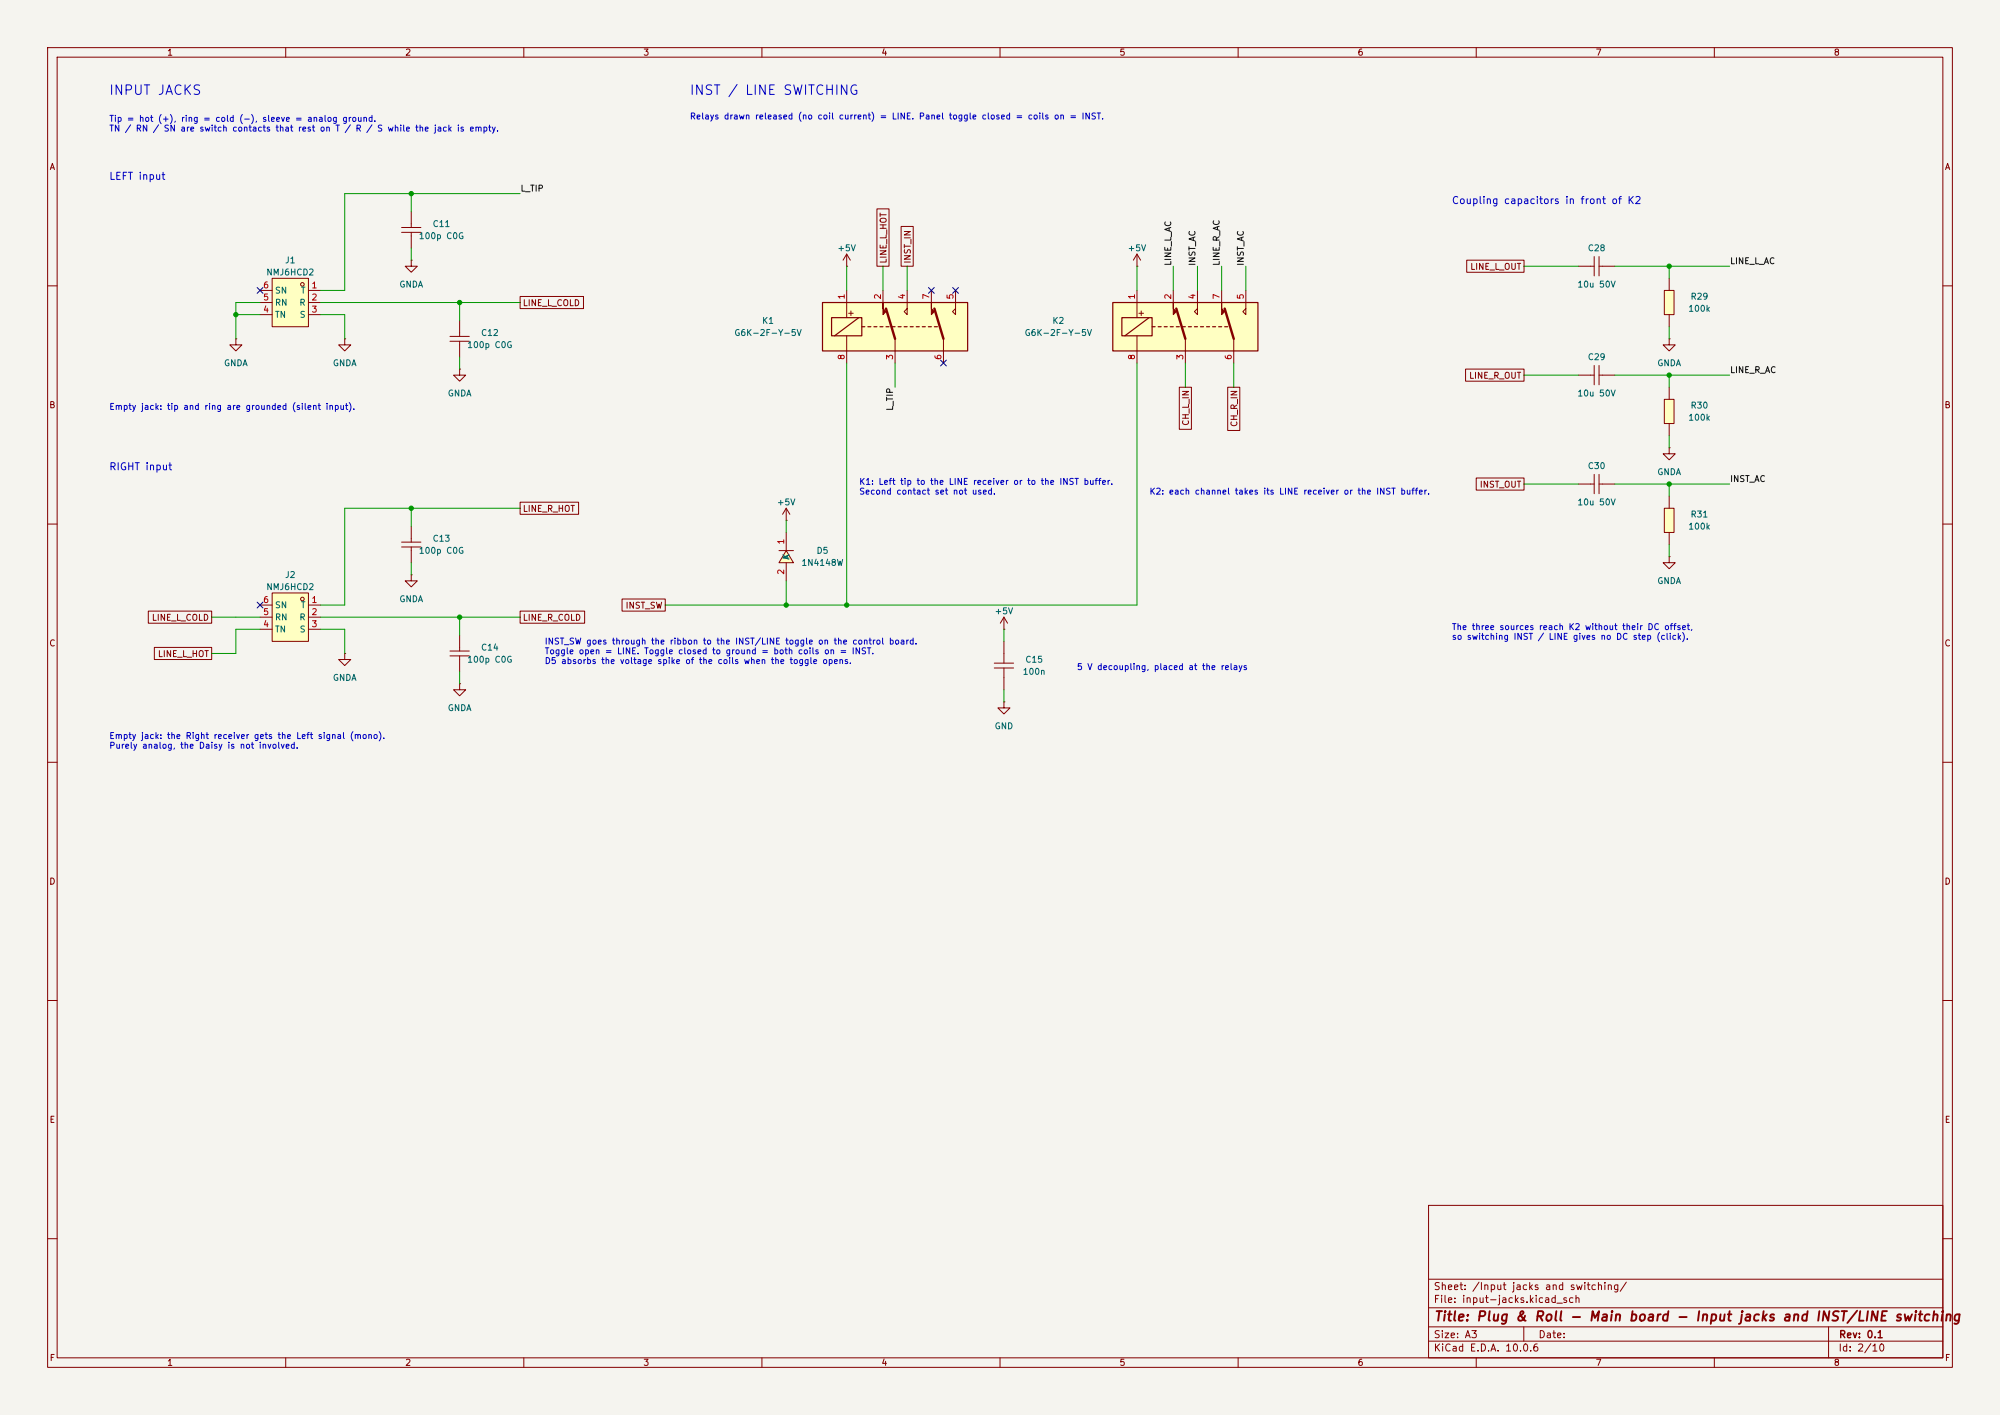
[picture p2: page 2]

INST_SW goes through the ribbon to the INST/LINE toggle on the control board. Toggle open = LINE. Toggle closed to ground = both coils on = INST. D5 absorbs the voltage spike of the coils when the toggle opens. K1: Left tip to the LINE receiver or to the INST buffer. Second contact set not used. Relays drawn released (no coil current) = LINE. Panel toggle closed = coils on = INST. INST / LINE SWITCHING

Tip = hot (+), ring = cold (-), sleeve = analog ground. TN / RN / SN are switch contacts that rest on T / R / S while the jack is empty.

Coupling capacitors in front of K2

K2: each channel takes its LINE receiver or the INST buffer. Empty jack: tip and ring are grounded (silent input).

The three sources reach K2 without their DC offset, so switching INST / LINE gives no DC step (click).

Empty jack: the Right receiver gets the Left signal (mono).
Purely analog, the Daisy is not involved.

Sheet: /Input jacks and switching/
File: input-jacks.kicad_sch
Title: Plug & Roll - Main board - Input jacks and INST/LINE switching

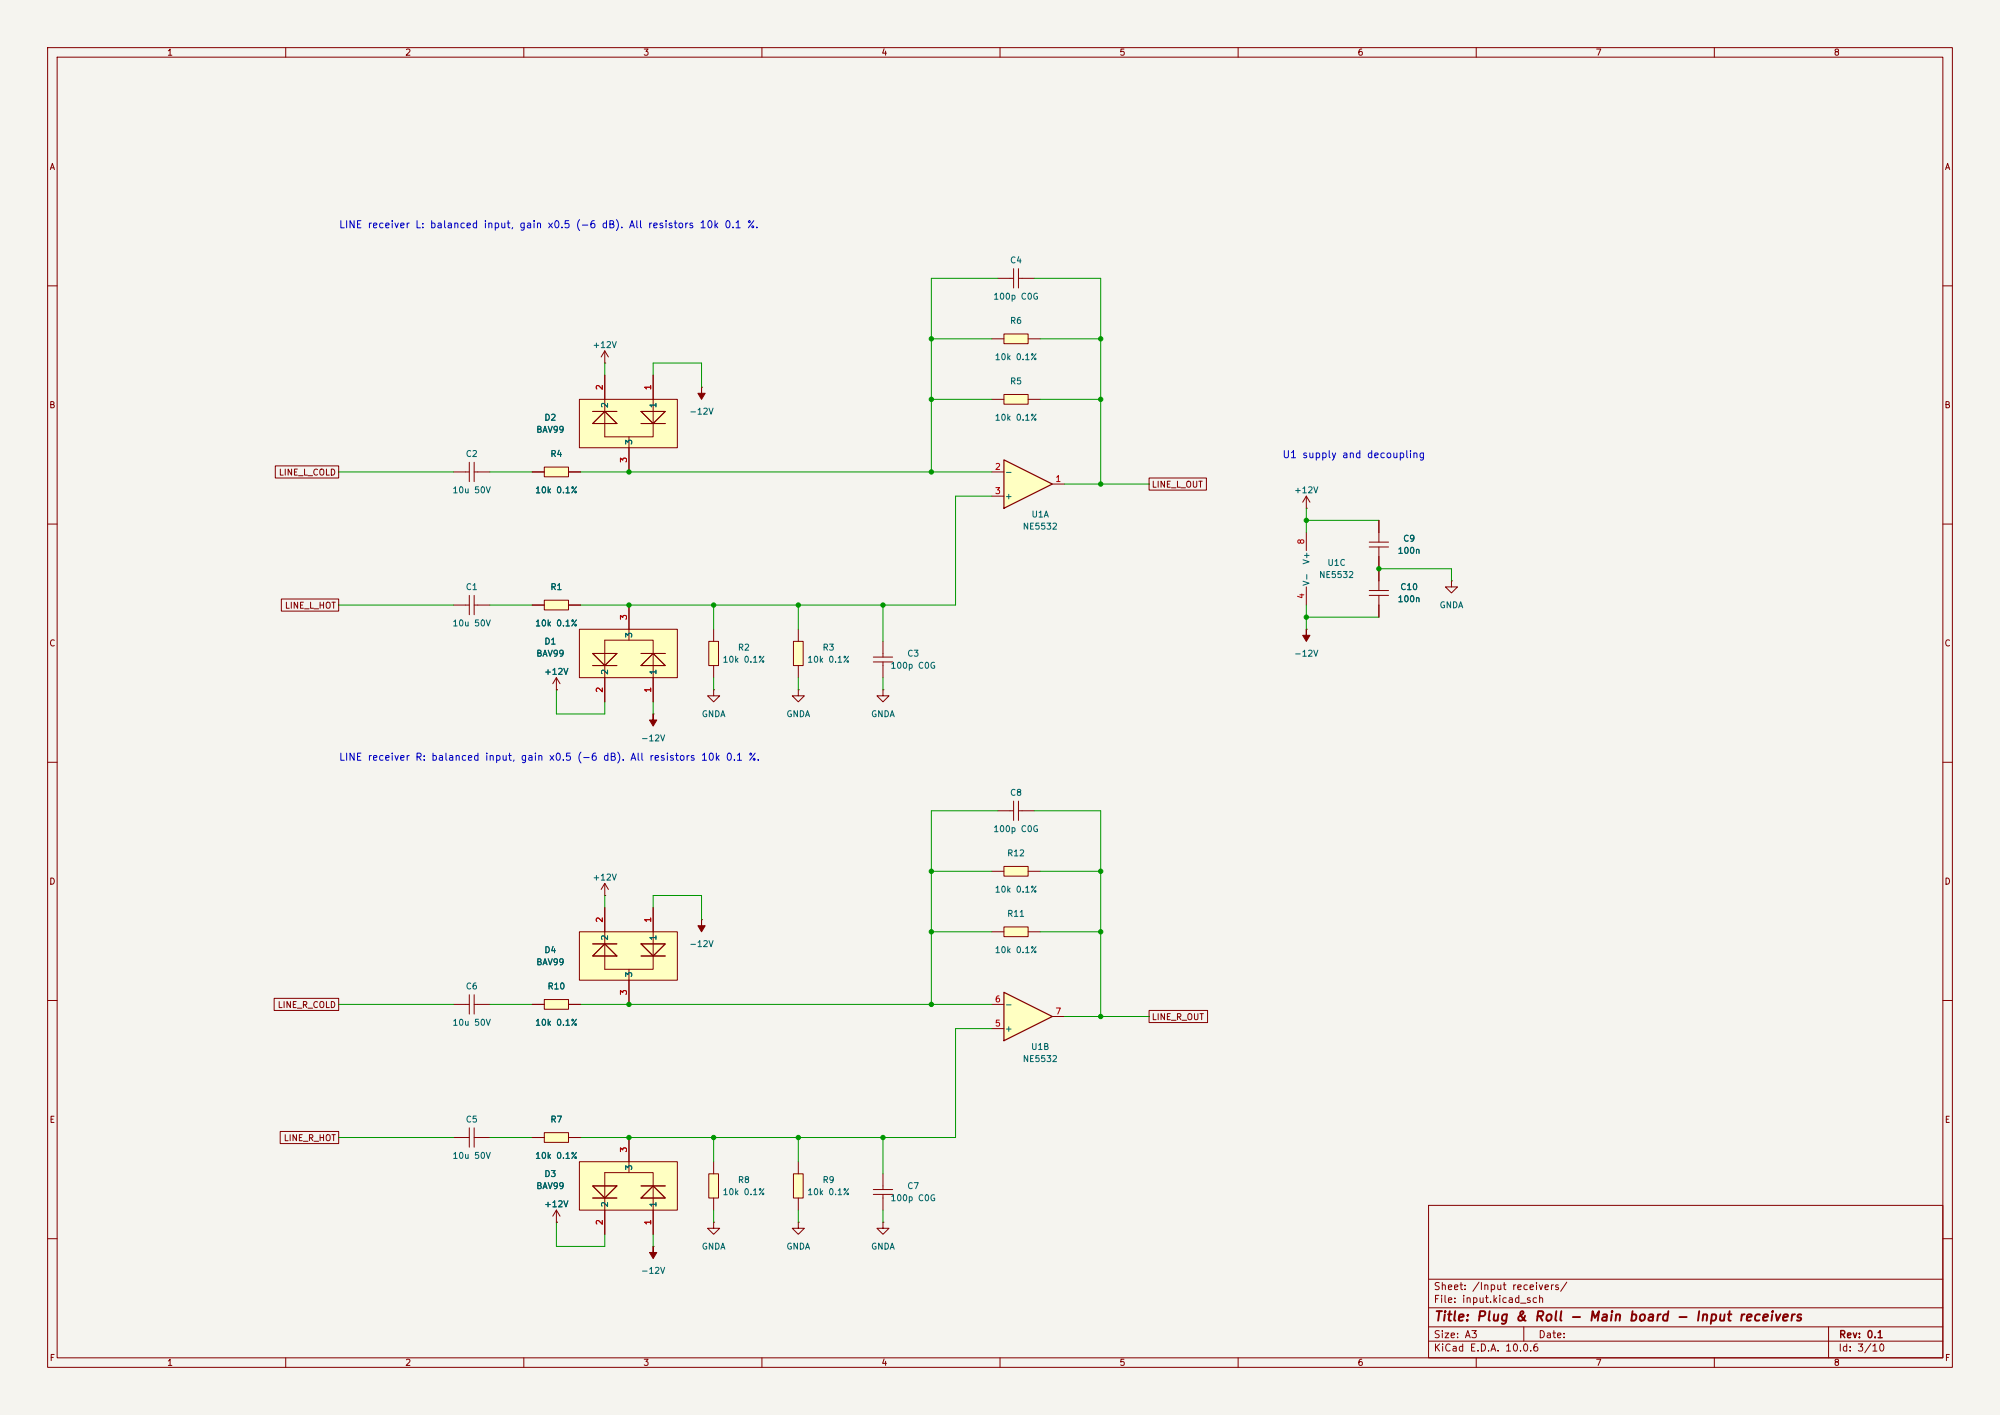
[picture p3: page 3]

LINE receiver L: balanced input, gain x0.5 (-6 dB). All resistors 10k 0.1 %.

LINE receiver R: balanced input, gain x0.5 (-6 dB). All resistors 10k 0.1 %. D1 BAV99

Sheet: /Input receivers/
File: input.kicad_sch
Title: Plug & Roll - Main board - Input receivers

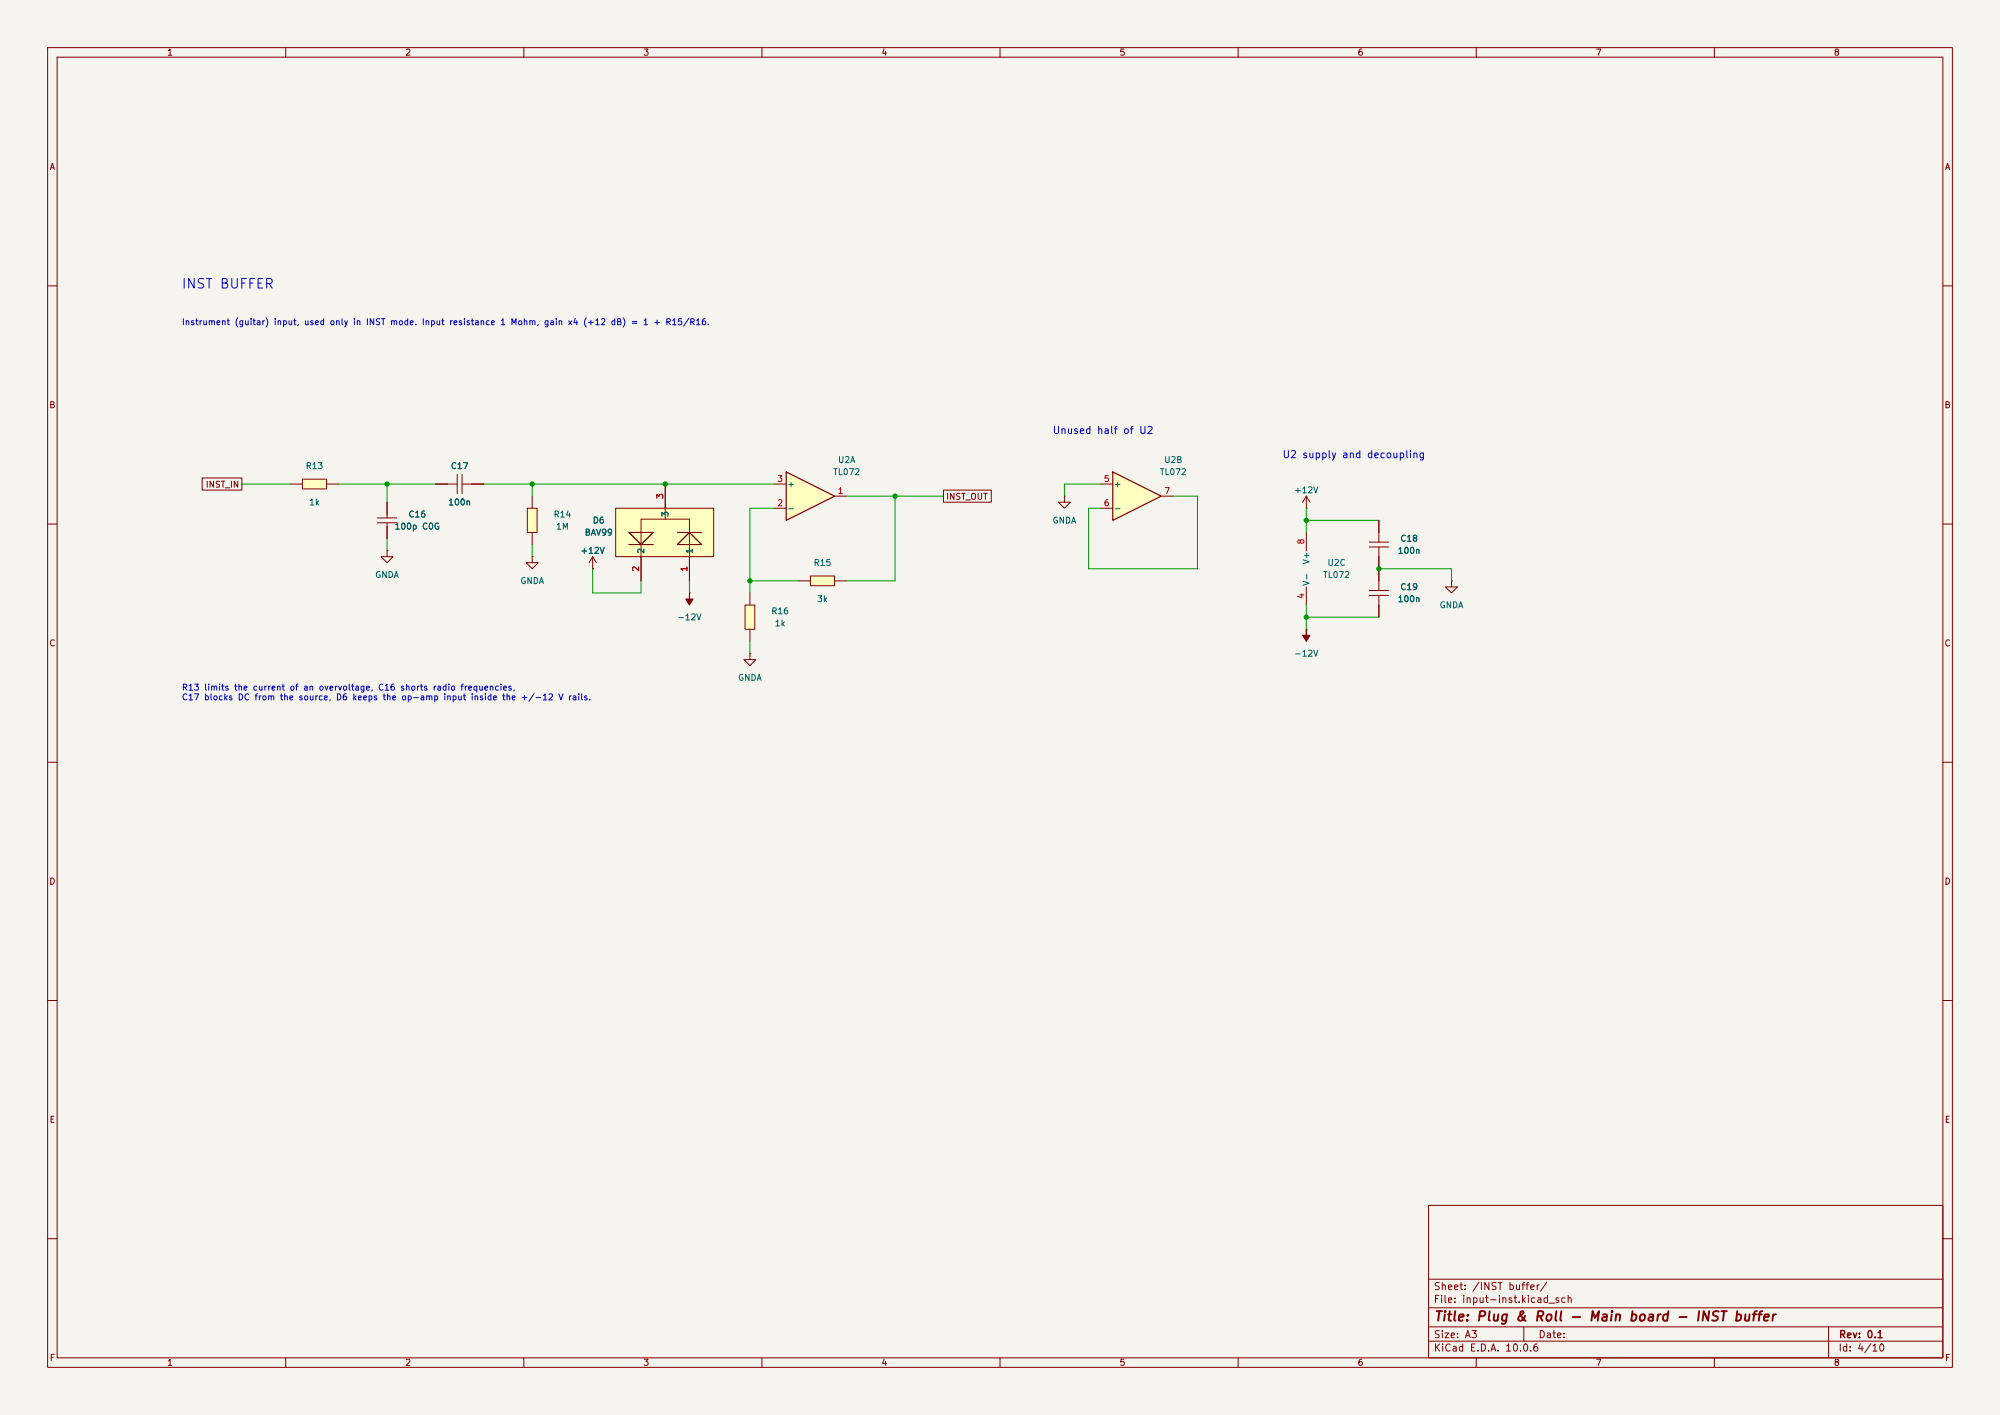
[picture p4: page 4]

Instrument (guitar) input, used only in INST mode. Input resistance 1 Mohm, gain x4 (+12 dB) = 1 + R15/R16.

R13 limits the current of an overvoltage, C16 shorts radio frequencies, C17 blocks DC from the source, D6 keeps the op-amp input inside the +/-12 V rails.

Sheet: /INST buffer/
File: input-inst.kicad_sch
Title: Plug & Roll - Main board - INST buffer

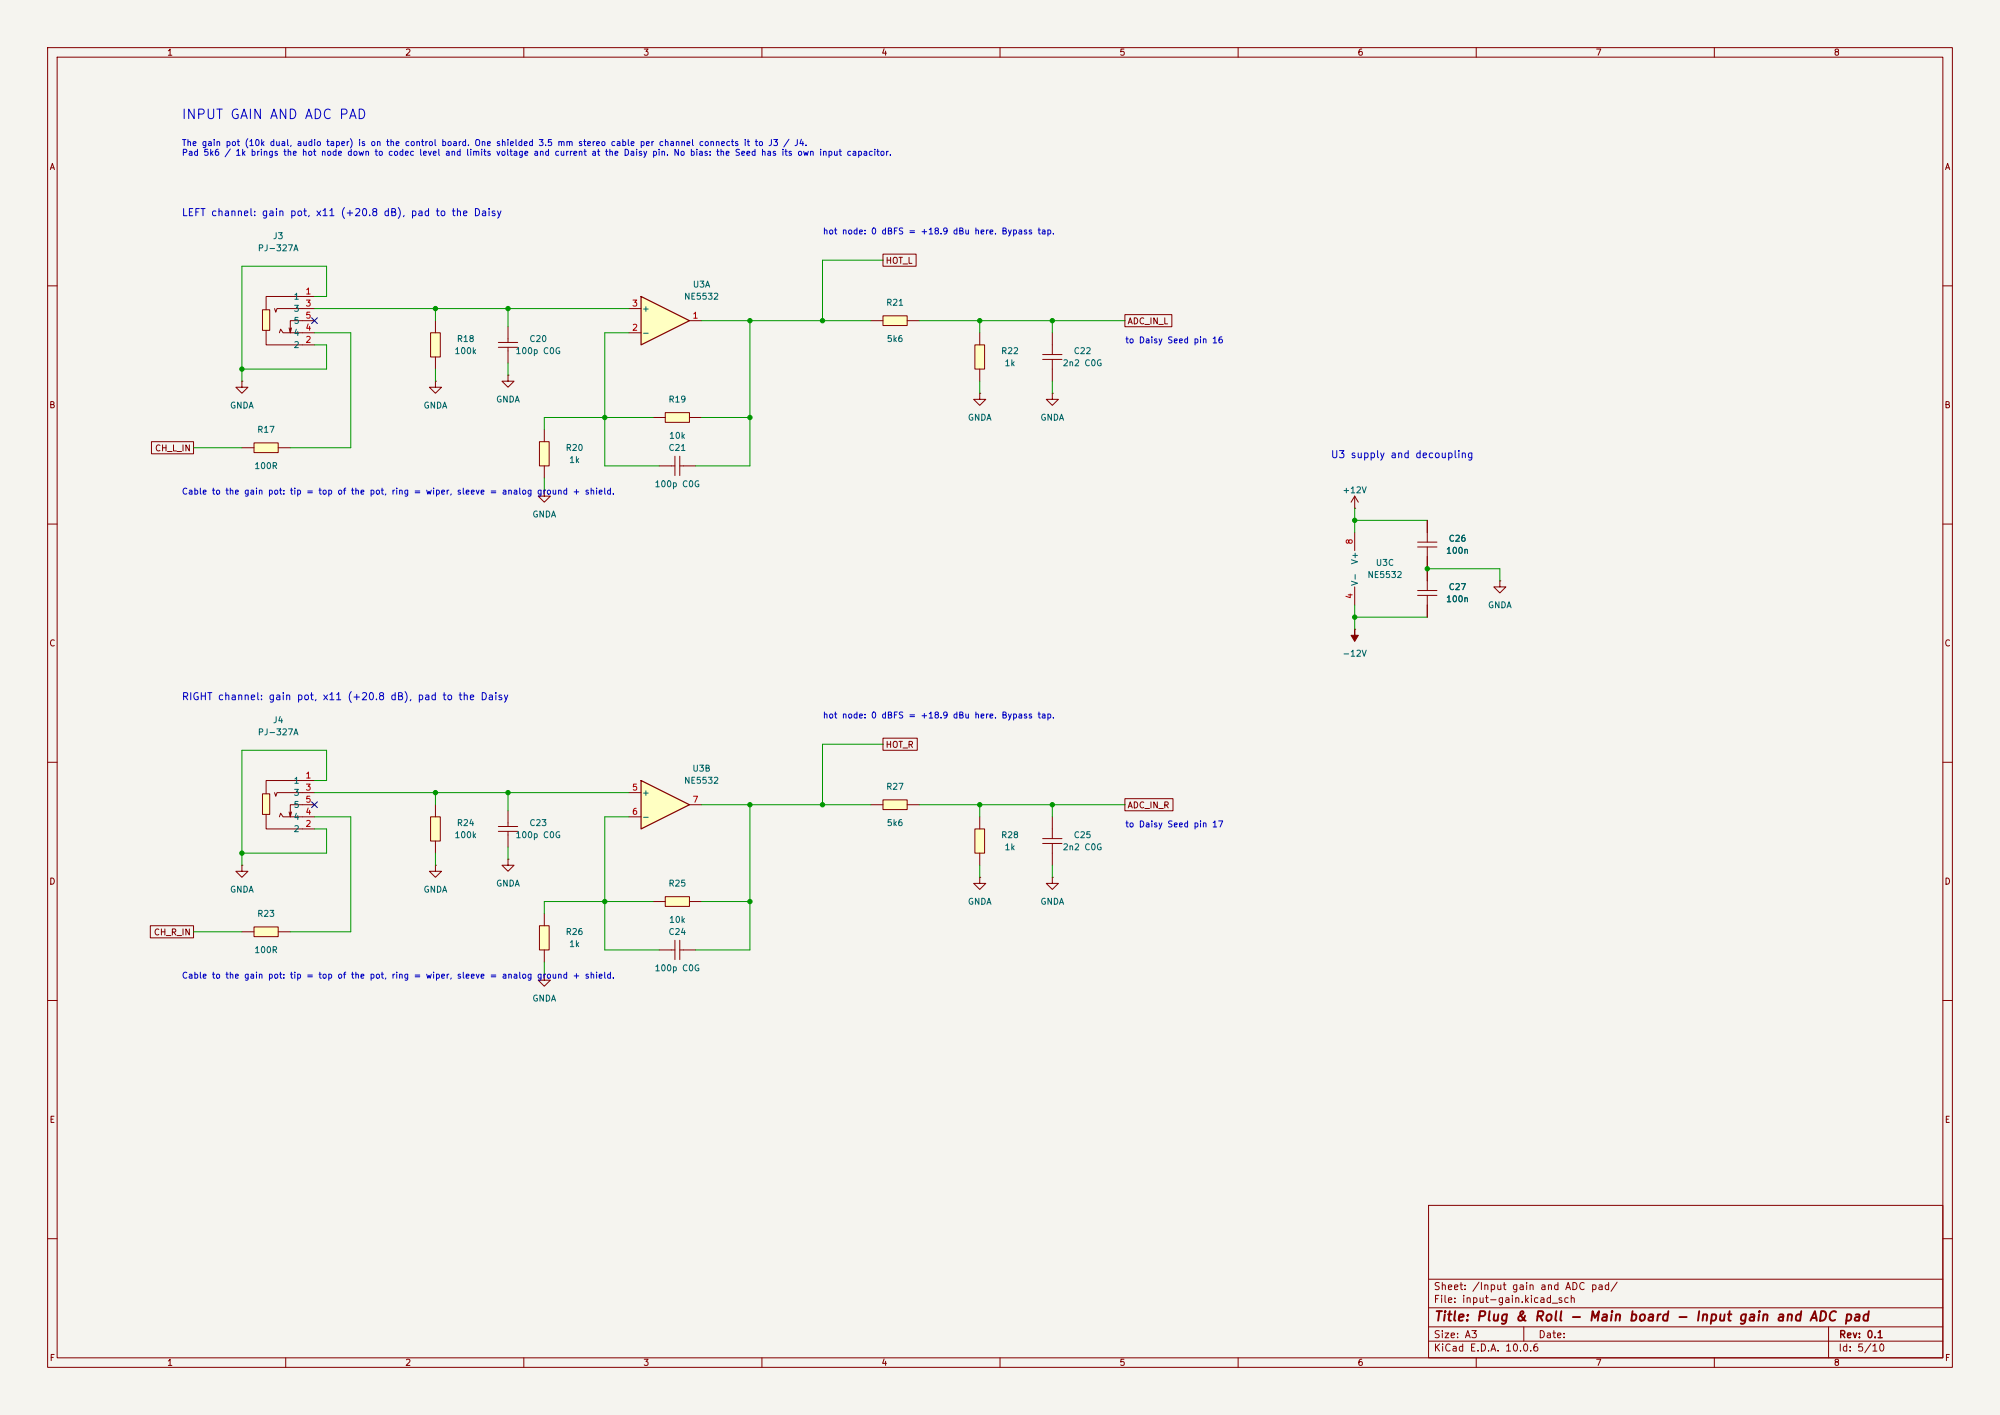
[picture p5: page 5]

INPUT GAIN AND ADC PAD
hot node: 0 dBFS = +18.9 dBu here. Bypass tap.
GNDA

The gain pot (10k dual, audio taper) is on the control board. One shielded 3.5 mm stereo cable per channel connects it to J3 / J4. Pad 5k6 / 1k brings the hot node down to codec level and limits voltage and current at the Daisy pin. No bias: the Seed has its own input capacitor.

LEFT channel: gain pot, x11 (+20.8 dB), pad to the Daisy

to Daisy Seed pin 16

to Daisy Seed pin 17 Cable to the gain pot: tip = top of the pot, ring = wiper, sleeve = analog ground + shield.

Sheet: /Input gain and ADC pad/
File: input-gain.kicad_sch
Title: Plug & Roll - Main board - Input gain and ADC pad

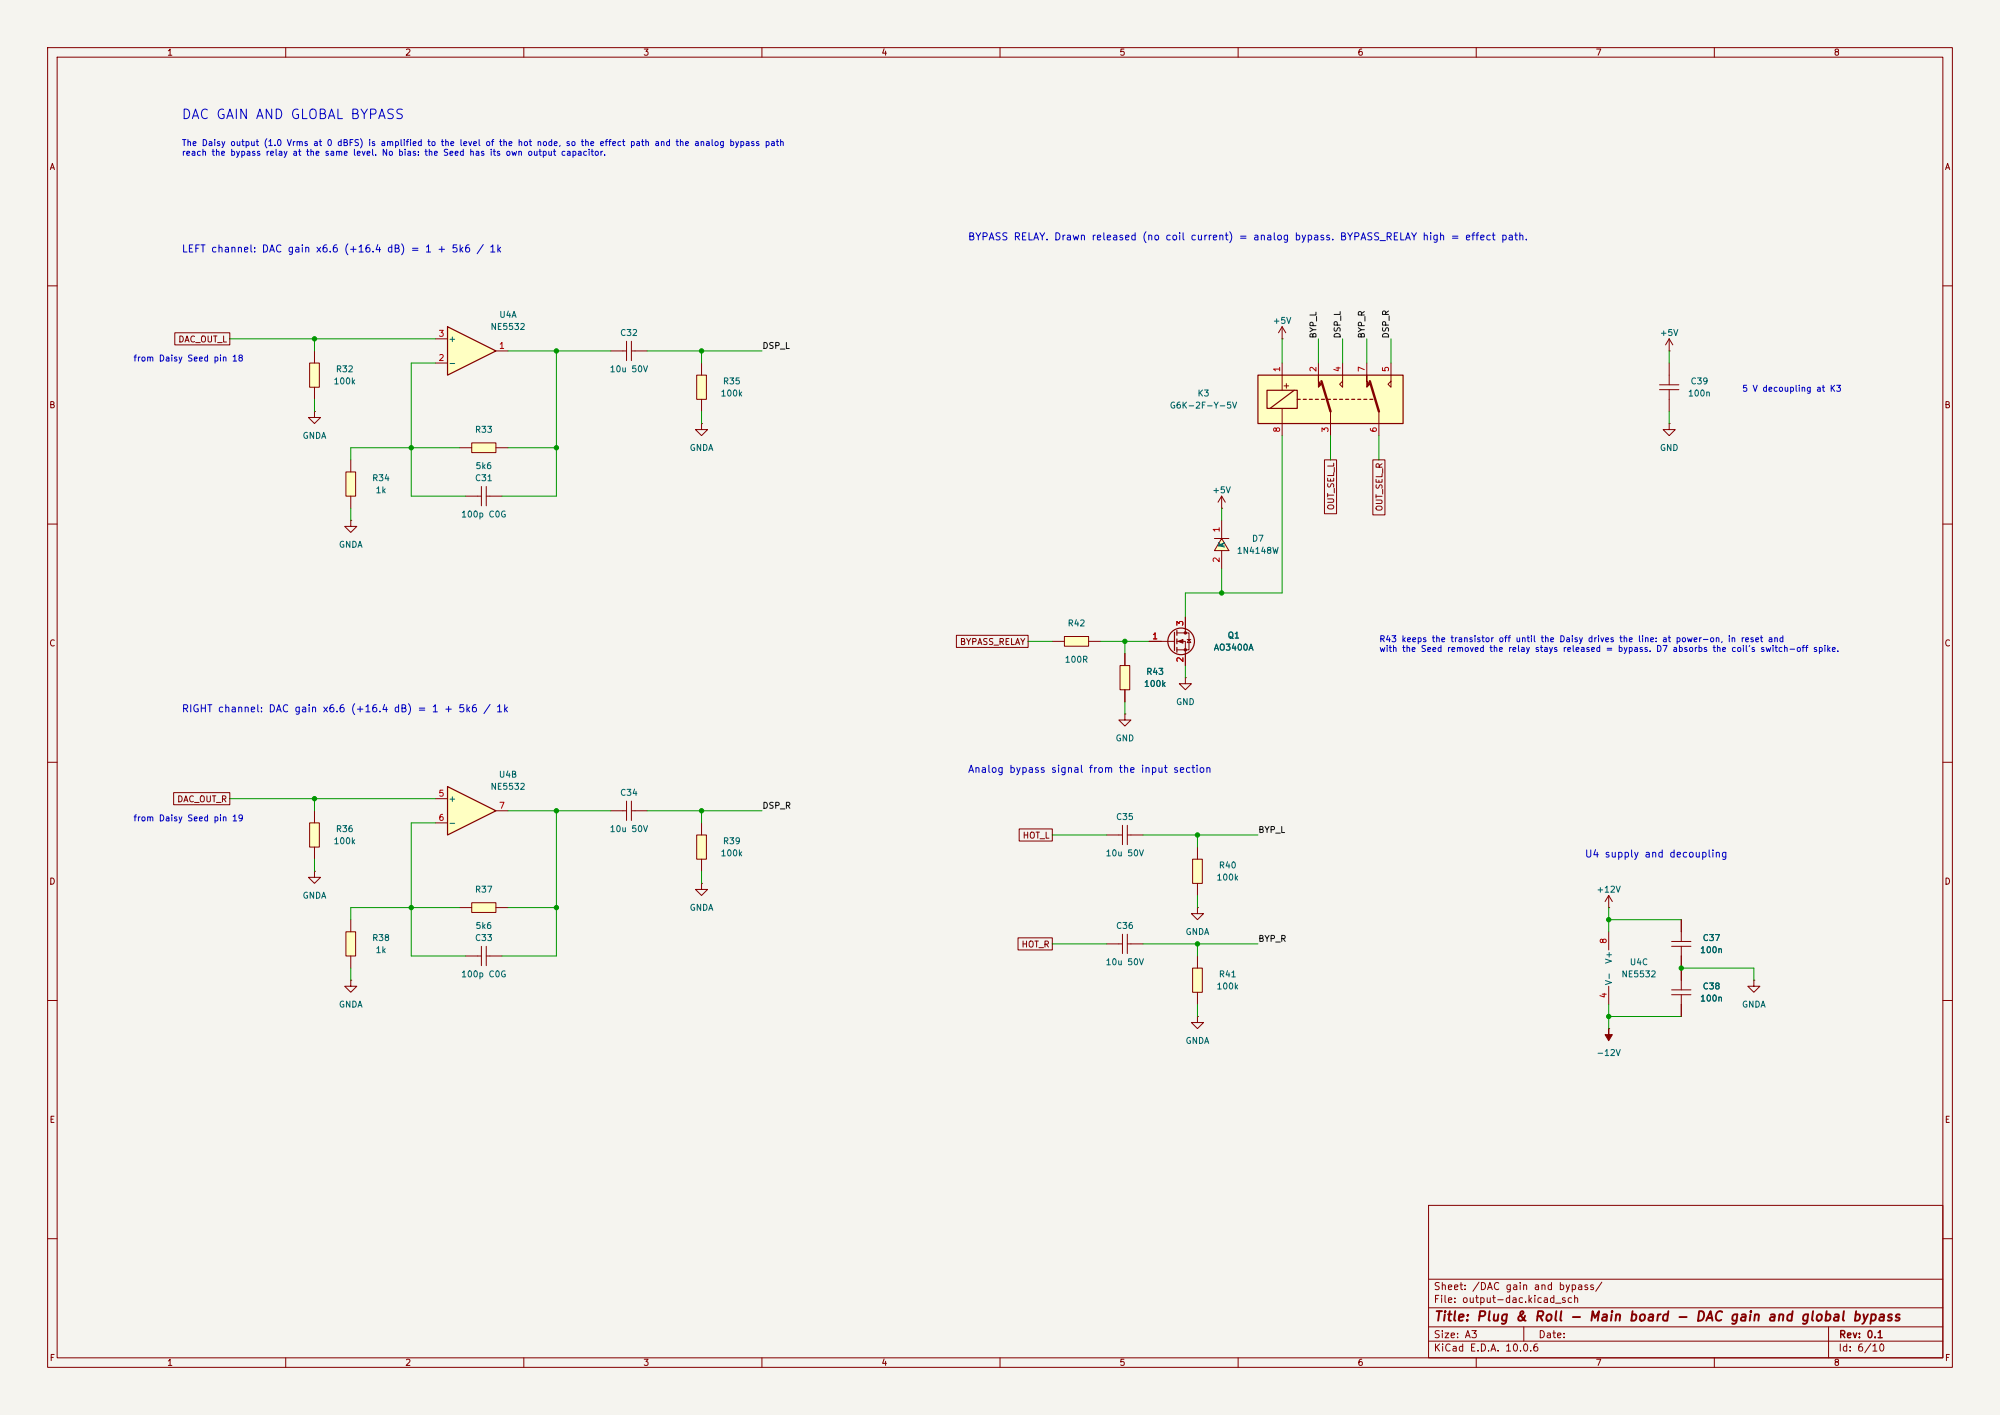
[picture p6: page 6]

DAC GAIN AND GLOBAL BYPASS

The Daisy output (1.0 Vrms at 0 dBFS) is amplified to the level of the hot node, so the effect path and the analog bypass path
reach the bypass relay at the same level. No bias: the Seed has its own output capacitor.

BYPASS RELAY. Drawn released (no coil current) = analog bypass. BYPASS_RELAY high = effect path.

LEFT channel: DAC gain x6.6 (+16.4 dB) = 1 + 5k6 / 1k

5 V decoupling at K3 R43 keeps the transistor off until the Daisy drives the line: at power-on, in reset and with the Seed removed the relay stays released = bypass. D7 absorbs the coil's switch-off spike.

RIGHT channel: DAC gain x6.6 (+16.4 dB) = 1 + 5k6 / 1k

Sheet: /DAC gain and bypass/
File: output-dac.kicad_sch
Title: Plug & Roll - Main board - DAC gain and global bypass

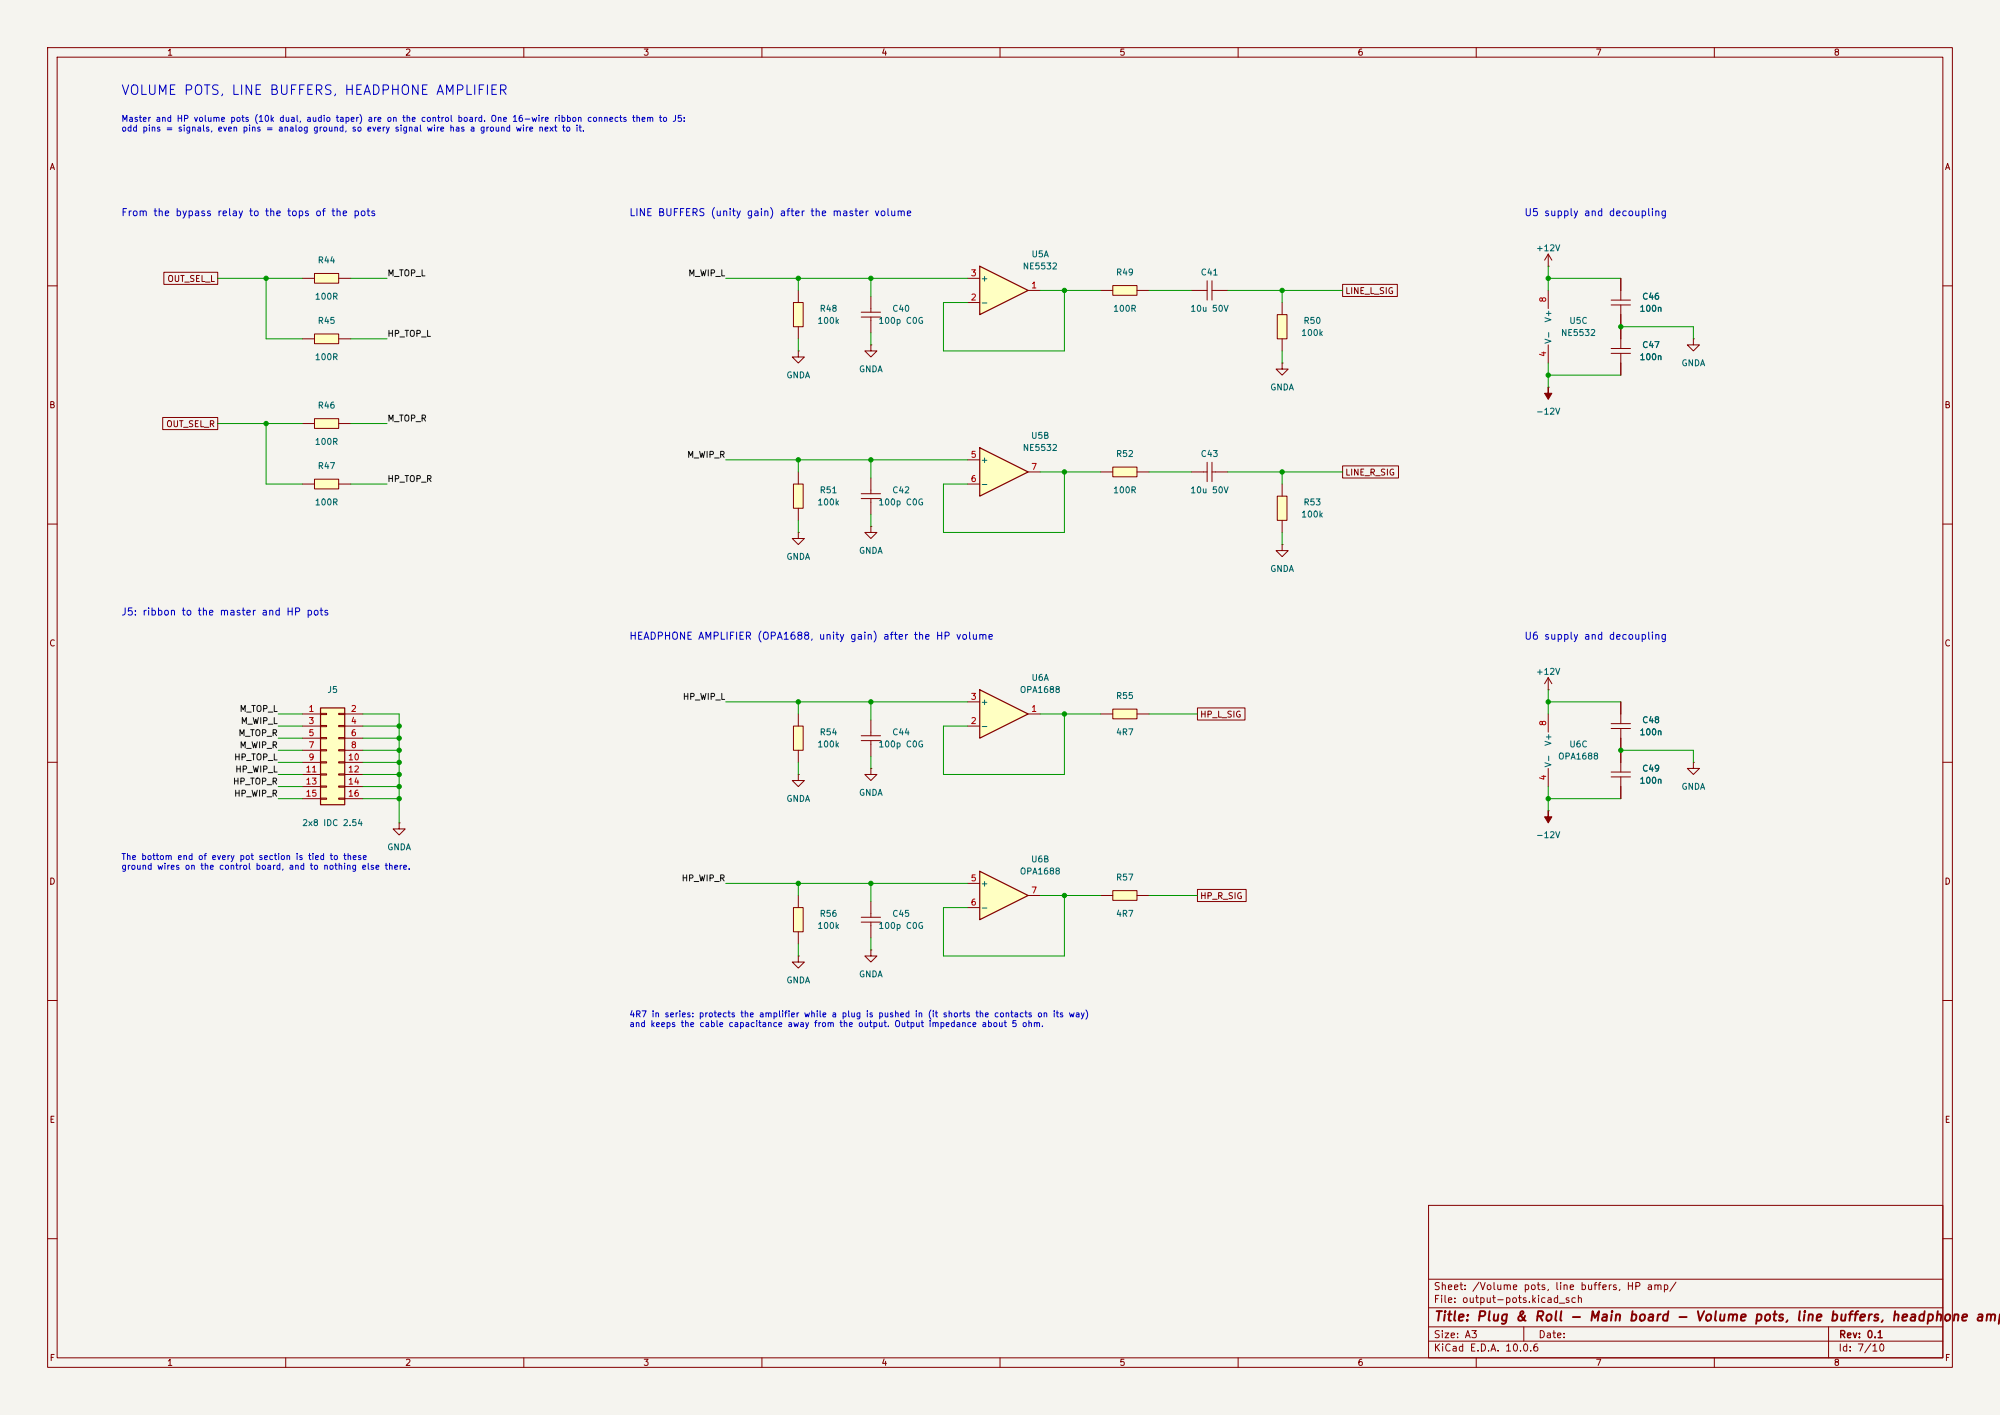
[picture p7: page 7]

J5: ribbon to the master and HP pots

Sheet: /Volume pots, line buffers, HP amp/
File: output-pots.kicad_sch
Title: Plug & Roll - Main board - Volume pots, line buffers, headphone amplifier

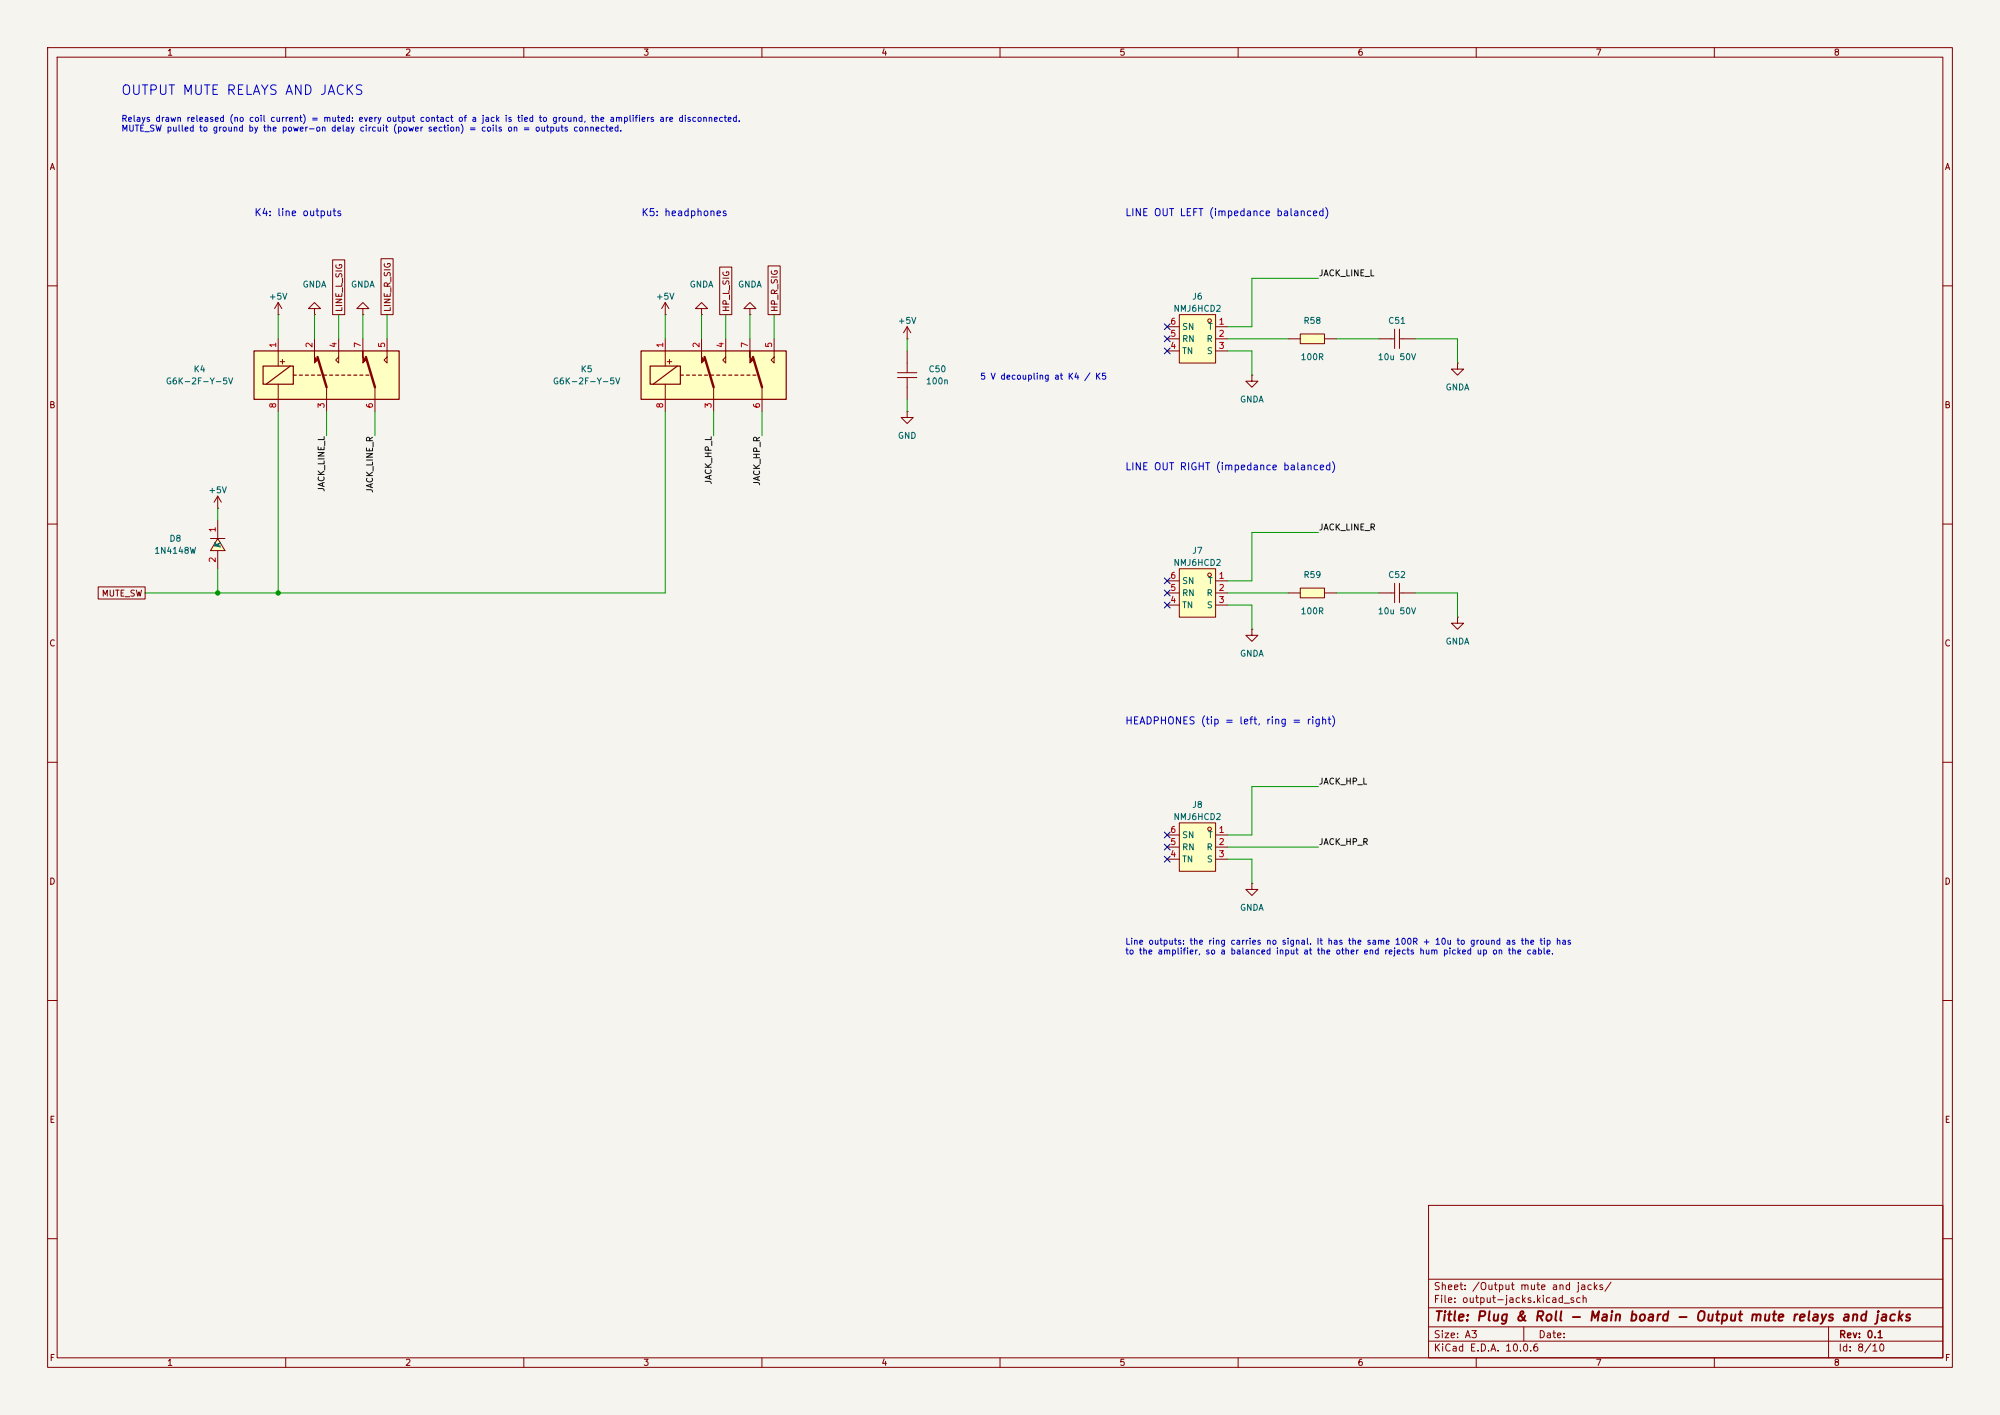
[picture p8: page 8]

OUTPUT MUTE RELAYS AND JACKS

Relays drawn released (no coil current) = muted: every output contact of a jack is tied to ground, the amplifiers are disconnected. MUTE_SW pulled to ground by the power-on delay circuit (power section) = coils on = outputs connected. K4: line outputs

LINE OUT LEFT (impedance balanced) 5 V decoupling at K4 / K5 K5: headphones

LINE OUT RIGHT (impedance balanced)

JACK_LINE_R HEADPHONES (tip = left, ring = right) Line outputs: the ring carries no signal. It has the same 100R + 10u to ground as the tip has

to the amplifier, so a balanced input at the other end rejects hum picked up on the cable.

Sheet: /Output mute and jacks/
File: output-jacks.kicad_sch
Title: Plug & Roll - Main board - Output mute relays and jacks

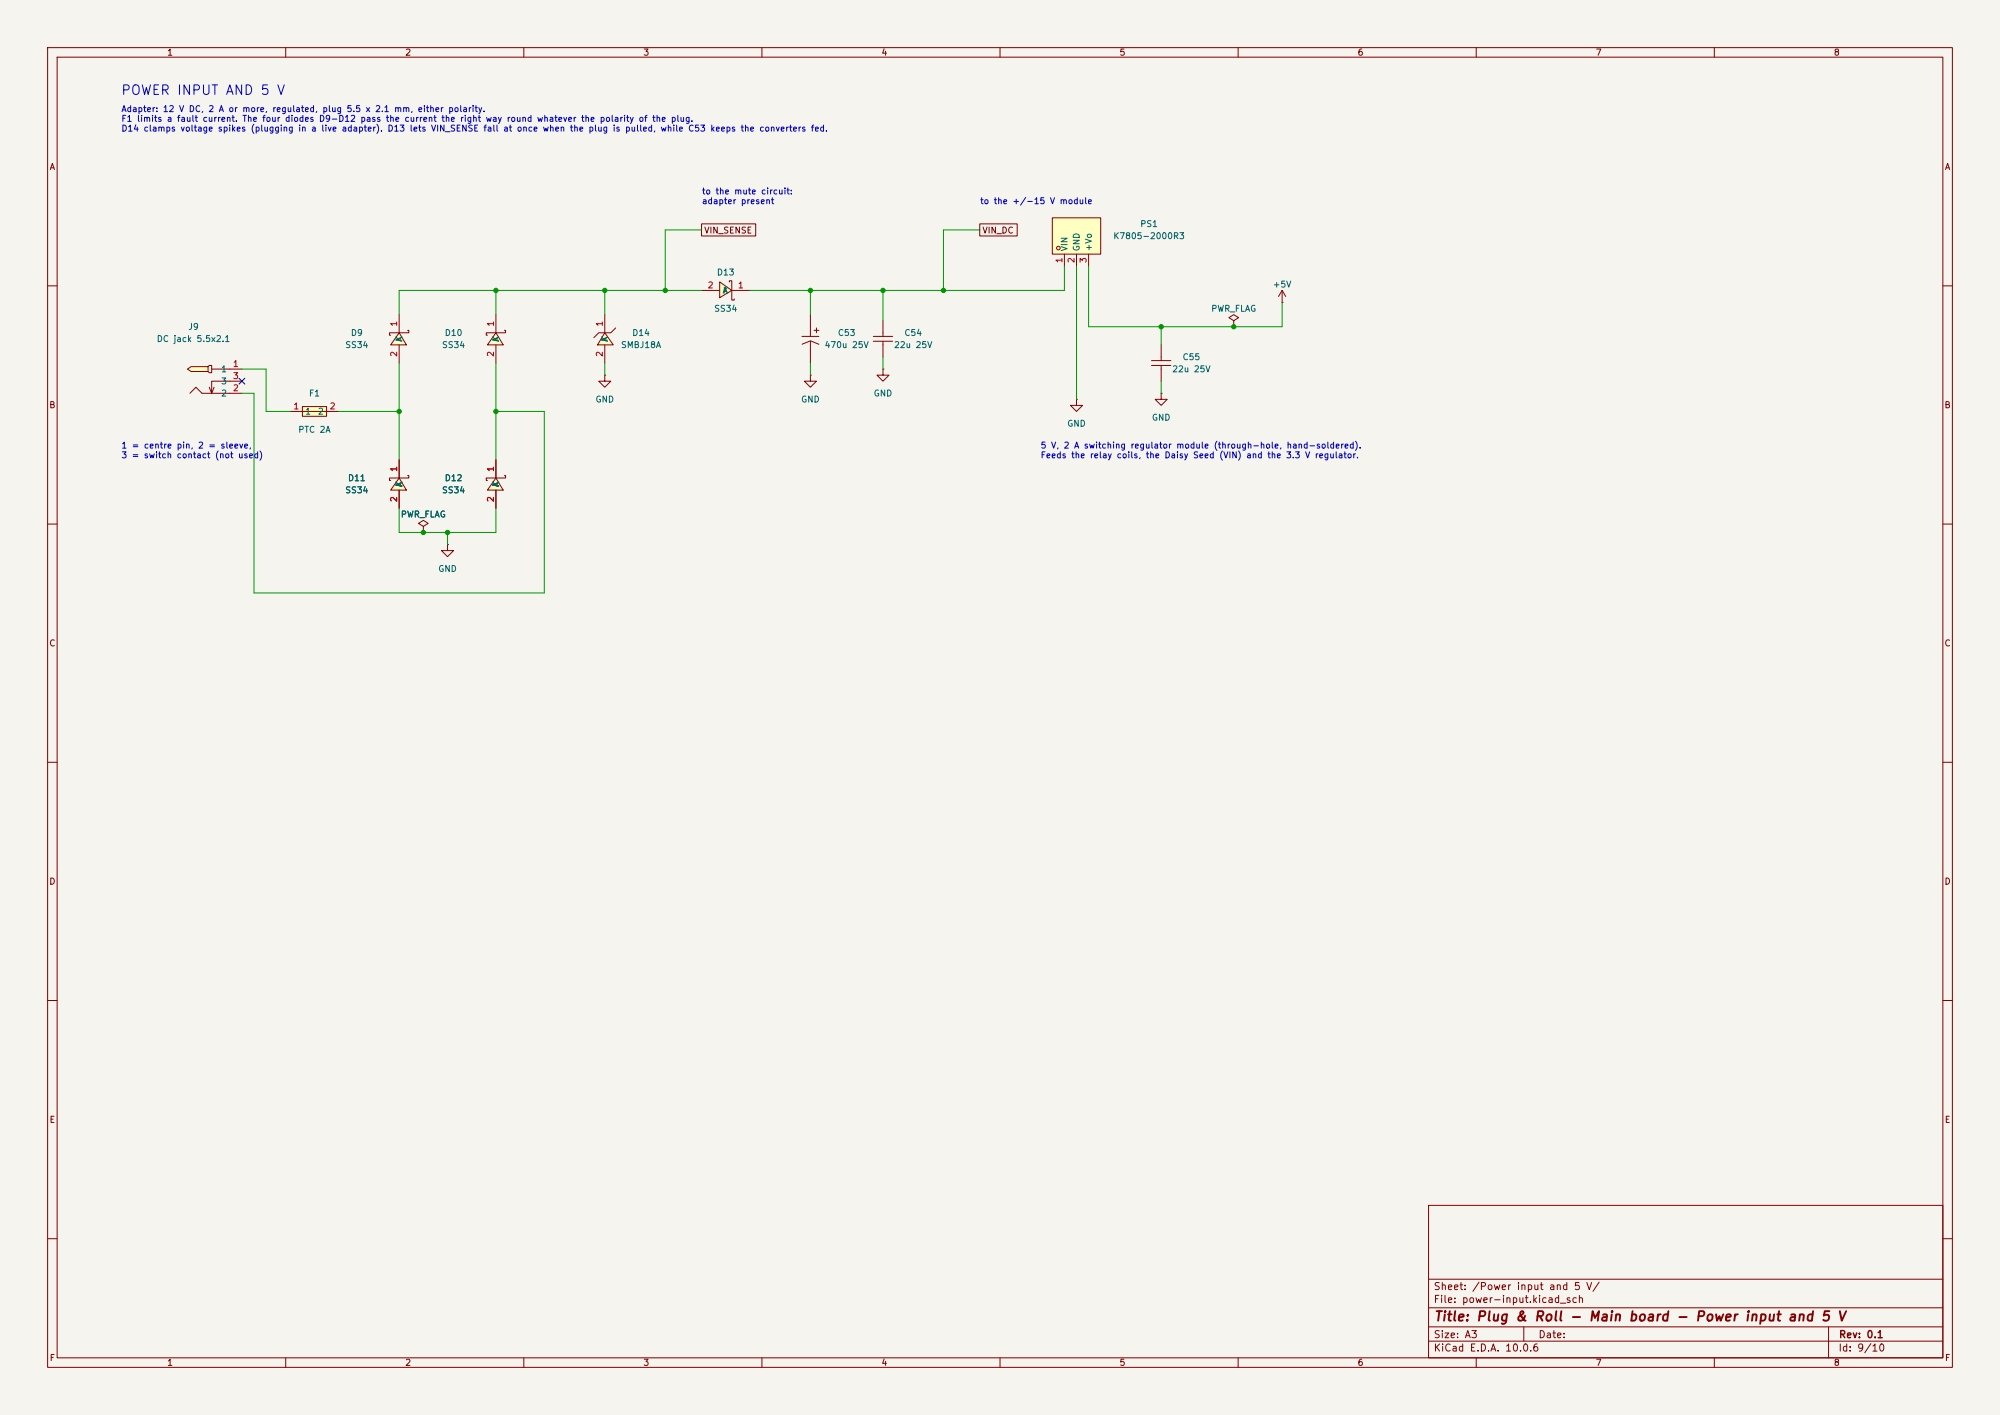
[picture p9: page 9]

Adapter: 12 V DC, 2 A or more, regulated, plug 5.5 x 2.1 mm, either polarity. F1 limits a fault current. The four diodes D9-D12 pass the current the right way round whatever the polarity of the plug. D14 clamps voltage spikes (plugging in a live adapter). D13 lets VIN_SENSE fall at once when the plug is pulled, while C53 keeps the converters fed. 1 = centre pin, 2 = sleeve, 3 = switch contact (not used)

Sheet: /Power input and 5 V/
File: power-input.kicad_sch
Title: Plug & Roll - Main board - Power input and 5 V

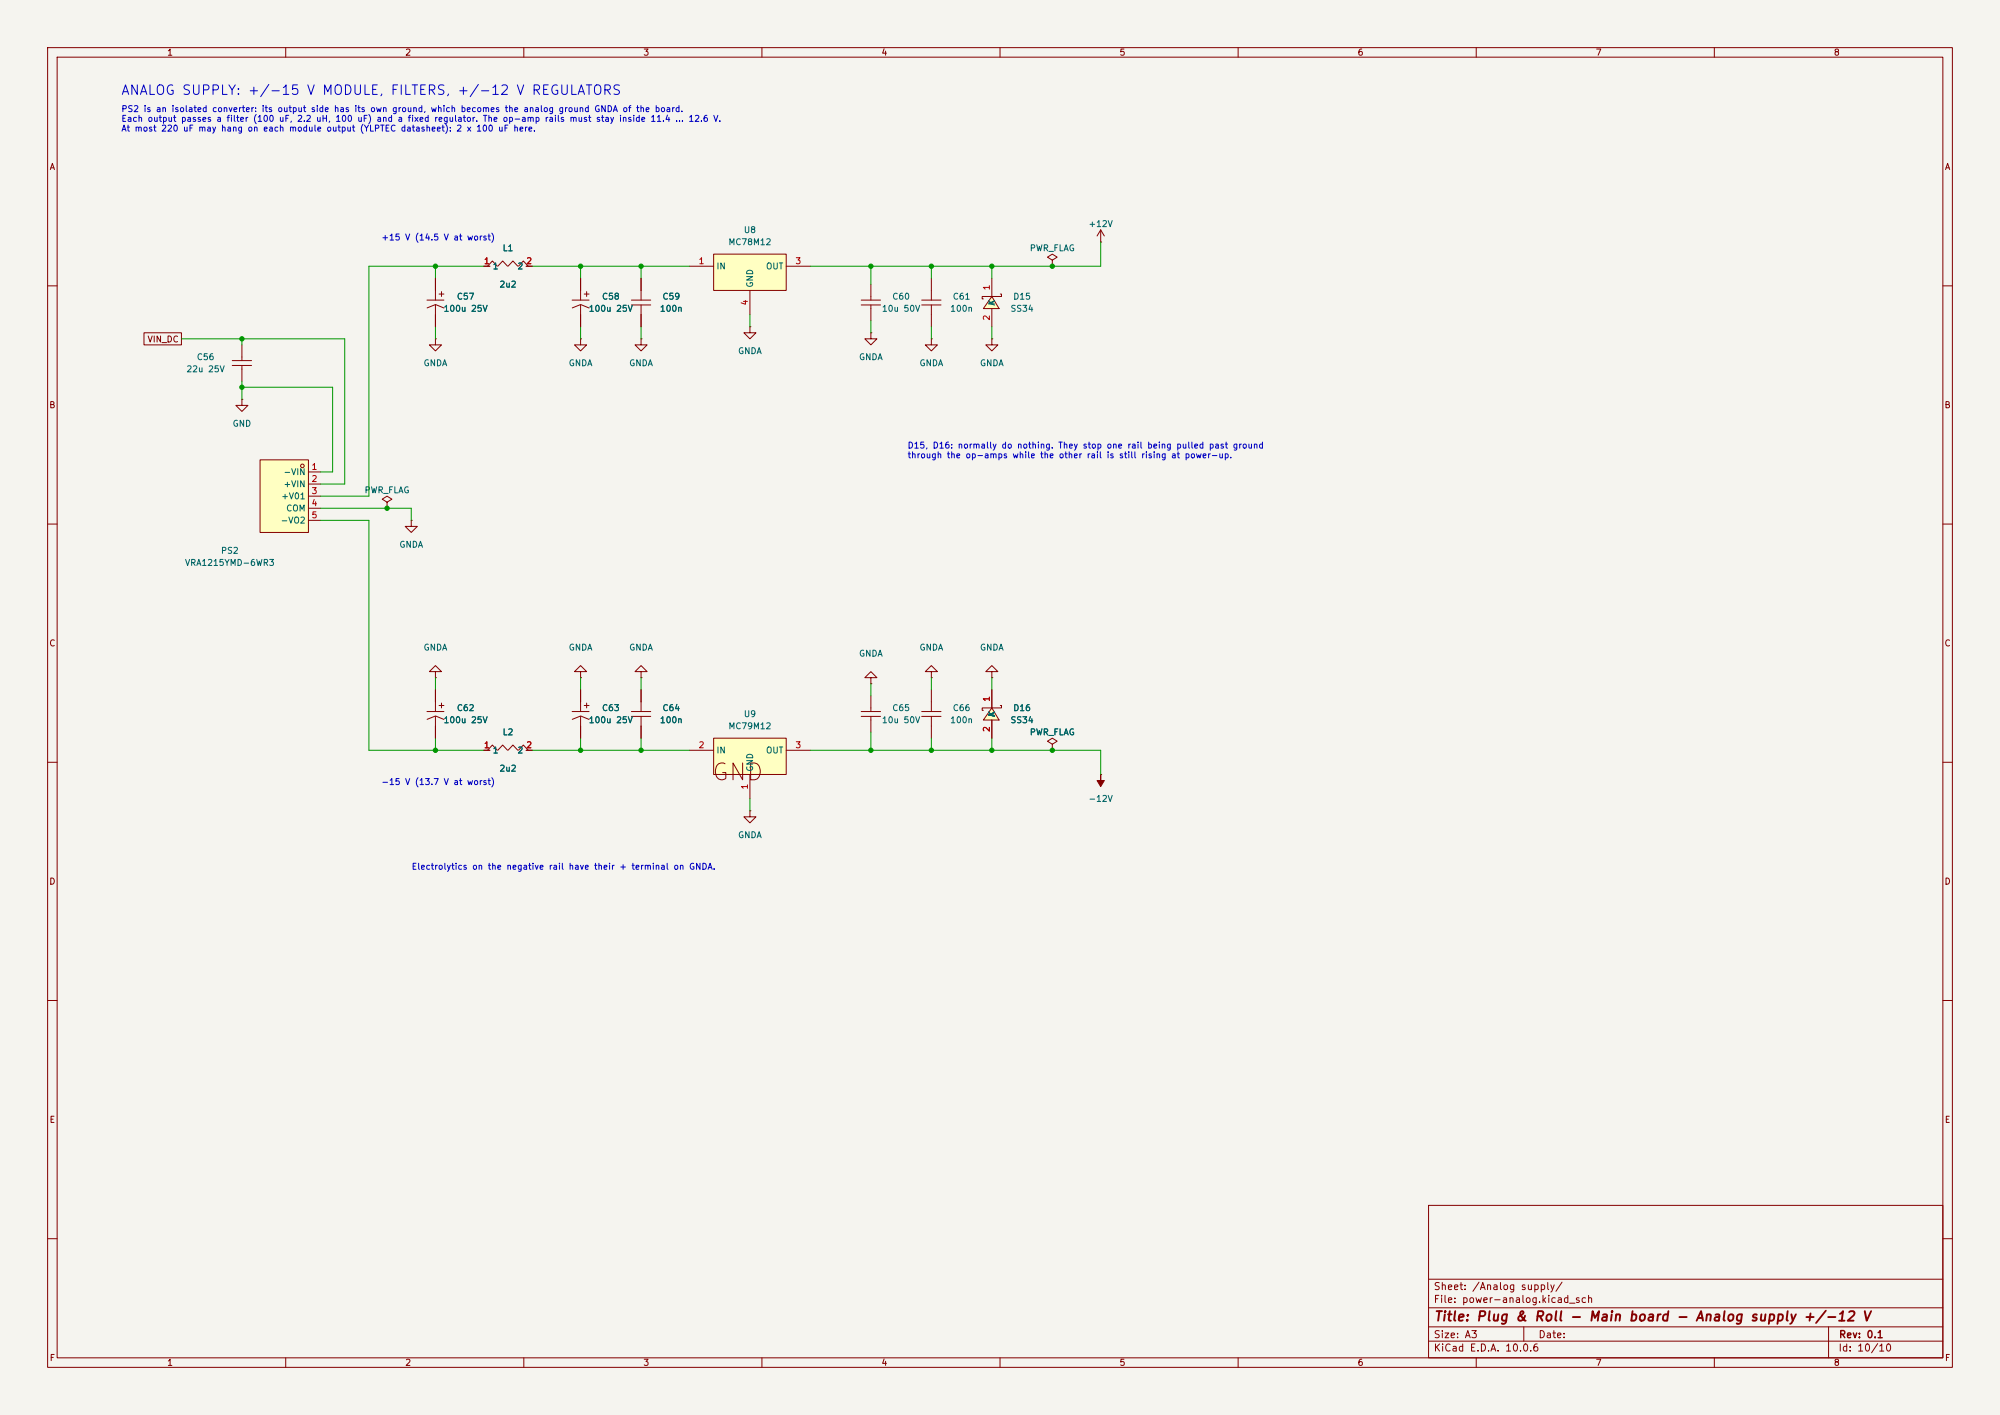
[picture p10: page 10]

through the op-amps while the other rail is still rising at power-up. +15 V (14.5 V at worst) PS2 is an isolated converter: its output side has its own ground, which becomes the analog ground GNDA of the board. Each output passes a filter (100 uF, 2.2 uH, 100 uF) and a fixed regulator. The op-amp rails must stay inside 11.4 ... 12.6 V. At most 220 uF may hang on each module output (YLPTEC datasheet): 2 x 100 uF here. ANALOG SUPPLY: +/-15 V MODULE, FILTERS, +/-12 V REGULATORS

D15, D16: normally do nothing. They stop one rail being pulled past ground

Electrolytics on the negative rail have their + terminal on GNDA.

Sheet: /Analog supply/
File: power-analog.kicad_sch
Title: Plug & Roll - Main board - Analog supply +/-12 V
