Tsakiris98/Plug-Roll---Digital-Audio-Multi-Effect-Device/hardware/main-board/main-board.kicad_pcb

## KiCad design schematic/schematic.kicad_sch


Parts:
A1: Arduino_UNO_R3
BT1: 6x1.5V
D1: LED; LED_Cree-XHP50_3V_HighDensity
DS1: HY1602E
Q1: NPN
R1, R2, R3, R6: 1k
R4: 410; HY1602E
R5: 10k; HY1602E
R7: 220
RV1: 10k; TSSOP-20_4.4x6.5mm_P0.65mm
SW1, SW2, SW3, SW5: SW_SPST; SW_NKK_GW12LJP
SW4: Tilt switch; WSON-8-1EP_6x5mm_P1.27mm_EP3.4x4mm
U1: (no value)

Connections:
+5V: A1.5 (+5V), DS1.4 (VDD), R6.2, RV1.3, SW1.1 (A), SW2.1 (A), SW3.1 (A), SW4.1 (A), SW5.2 (B), U1.1 (Vcc)
+9V: A1.8 (VIN), BT1.1 (+)
GND: A1.7 (GND), D1.1 (K), DS1.1 (LEDK), DS1.3 (VSS), DS1.7 (R/~W), Q1.3 (E), R1.2, R2.2, R3.2, R5.2, RV1.1, U1.4 (GND)
GNDPWR: A1.29 (GND), BT1.2 (-)
LCD_D4: A1.20 (D5), DS1.13 (DB4)
LCD_D5: A1.19 (D4), DS1.14 (DB5)
LCD_D6: A1.18 (D3), DS1.15 (DB6)
LCD_D7: A1.17 (D2), DS1.16 (DB7)
LCD_Enable: A1.26 (D11), DS1.8 (E)
LCD_RS: A1.27 (D12), DS1.6 (RS)
unnamed: D1.2 (A), Q1.1 (C), R6.1
unnamed: DS1.2 (LEDA), R4.1
unnamed: DS1.5 (Vo), RV1.2
unnamed: Q1.2 (B), R7.2
unnamed: R4.2, SW5.1 (A)
PIN_BTN_LEFT: A1.10 (A1), R1.1, SW1.2 (B)
PIN_BTN_OK: A1.12 (A3), R3.1, SW3.2 (B)
PIN_BTN_RIGHT: A1.11 (A2), R2.1, SW2.2 (B)
PIN_BZZ_LED: A1.21 (D6), R7.1
PIN_TILT: A1.28 (D13), R5.1, SW4.2 (B)
PIN_US_ECHO: A1.23 (D8), U1.3 (Echo)
PIN_US_TRIG: A1.24 (D9), U1.2 (Trig)

Notes on the sheet:
LCD schematic
Buttons schematic
LCD Contrast potentiometer
From battery holder
LCD Backlight switch
Ultrasonic Sensor
From Arduino regulator
