Tsakiris98/Plug-Roll---Digital-Audio-Multi-Effect-Device/(commit log)

2026-11-12 Initial project structure: Claude instructions, READMEs, empty main-board KiCad project
    - CLAUDE.md with the hardware, collaboration and firmware rules
    - README files for the repository and the hardware folder
    - Empty KiCad 10 project for the main board (created in KiCad)
    - .gitignore for macOS, KiCad local files and firmware build output
    [main-board.kicad_pcb, main-board.kicad_sch]
2026-11-12 Add requirements v0.3 and input section design note
    Requirements v0.3 (docs/requirements.md is the single source of truth):
    - INST/LINE switching with signal relays driven by the Daisy through a
    transistor; the panel toggle is read by a GPIO only. Relays released
    (LINE) until the firmware drives them.
    - ADC protected by a resistive pad in front of the Daisy audio input
    instead of clamp diodes; bypass tap before the pad, DAC path gain equal
    to the pad attenuation.
    - Mono in LINE mode with the normalling contacts of the Right input jack,
    at the Right receiver input; sleeve contact to a GPIO.
    - Analog pots stay on the control board, connected with shielded analog
    cables separate fro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
2026-11-12 Input section v0.5: parts, schematic of jacks, INST/LINE relays and LINE receivers
    Design decisions (docs/requirements.md v0.5, docs/input-section.md v0.5):
    - SMD wherever a part exists in SMD; parts selected and checked at JLCPCB.
    - ADC pad 5.6k/1k, fixed gain x11, receivers from 10k 0.1 % only.
    - Gain pot connected with shielded 3.5 mm cables; general ribbon for the rest.
    - Analog switching is not controlled by the Daisy: the INST/LINE toggle
    switches the relay coils directly (INST_SW, closes to ground). No
    transistor driver, no mono-detection pin. Global bypass stays Daisy-driven.
    - Relay pinout taken from the Omron G6K datasheet; Daisy audio pins 16-19.
    Schematic (generated by tools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
    [input-jacks.kicad_sch, input.kicad_sch, main-board.kicad_sch]
2026-11-12 Input section: INST buffer schematic (TL072, 1 Mohm, gain x4)
    input-inst.kicad_sch: 1k series, 100 pF RF shunt, 100 nF DC block into
    1 Mohm, BAV99 clamp at the op-amp input, non-inverting gain 1 + 3k/1k.
    The clamp sits after the blocking capacitor (a step at the jack passes
    through the capacitor, so a clamp in front would not protect the op-amp);
    design note section 9 updated. Unused half of U2 tied off as a follower
    of ground.
    Netlist matches the intended circuit (tools/schgen/verify.py). ERC: 7
    expected findings (2 labels waiting for the gain stages, 5 rails without
    a source yet).
    [input-inst.kicad_sch, main-board.kicad_sch]
2026-11-12 Input section: gain stages and ADC pad schematic
    input-gain.kicad_sch, per channel: 100R to the gain pot cable (PJ-327A
    3.5 mm jack: tip = pot top, ring = wiper, sleeve = analog ground), 100k
    and 100 pF at the wiper input, NE5532 non-inverting x11 (10k / 1k) with
    100 pF across the feedback resistor, hot node label HOT_L / HOT_R (bypass
    tap), pad 5k6 / 1k with 2n2 C0G to ADC_IN_L / ADC_IN_R (Daisy pins 16, 17).
    Design note: the two added 100 pF capacitors explained; pot rustle from
    the NE5532 input current recorded as a prototype check, with a TL072 in
    U3 as a drop-in fallback. Decision 2026-11-12: keep the NE5532 in U3.
    Netlist matches the intended circuit. ERC: 5 findings, all supply rail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
    [input-gain.kicad_sch, main-board.kicad_sch]
2026-11-12 Output section: design note, requirements v0.6, DAC gain and bypass relay schematic
    docs/output-section.md (approved 2026-11-12): DAC gain x6.6, bypass relay
    driven by the Daisy with released = analog bypass, no firmware mute (coupling
    capacitors remove the DC step), impedance-balanced line outputs, power-up
    mute by relays and an analog delay circuit, master/HP pots on a separate
    16-wire ribbon, headphone amplifier OPA1688 with the TPA6120A2 recorded as
    the upgrade path (section 8.1). Requirements updated to v0.6.
    Schematic:
    - output-dac.kicad_sch: NE5532 gain stage from Daisy pins 18/19, coupling
    capacitors, bypass relay K3 with AO3400A driver (BYPASS_RELAY).
    - input-jacks.kicad_sch: cou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
    [input-jacks.kicad_sch, main-board.kicad_sch, output-dac.kicad_sch]
2026-11-13 Output section complete: volume pot header, line buffers, headphone amplifier, mute relays, jacks
    - output-pots.kicad_sch: 100R feeds to the tops of the master and HP pots,
    2x8 IDC header J5 (odd pins signals, even pins analog ground), NE5532
    line buffers with 100R + 10 uF outputs, OPA1688 headphone followers with
    4R7 in series.
    - output-jacks.kicad_sch: mute relays K4 (line) and K5 (headphones) as
    changeover contacts (released = jack contact grounded, amplifier
    disconnected), coil line MUTE_SW for the power section, impedance-balanced
    line jacks, headphone jack.
    Decisions recorded in docs/output-section.md: J5 through-hole (the SMD
    version has 113 in stock; a cable header needs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
    [main-board.kicad_sch, output-jacks.kicad_sch, output-pots.kicad_sch]
2026-11-13 Power section design note v0.3 and requirements v0.7
    Decisions of 2026-11-13: 12 V / 2 A regulated adapter (the 9-15 V range is
    dropped; 15 V works, 9 V does not), polarity bridge kept, ready-made
    converter modules instead of converters built from parts.
    - +/-15 V: VRA1215YMD-6WR3 (6 W, isolated), then LC filters and fixed
    +/-12 V regulators.
    - +5 V: K7805-2000R3 (2 A) for the Daisy Seed, relay coils and the 3.3 V
    regulator.
    - Worst-case budget about 10.5 W.
    - Section 5.1 records what the YLPTEC datasheets say (pin-outs, 220 uF
    maximum per output, -15 V load regulation, no hot plugging) and what that
    changes in the design.
    - Analog power-on/power-off mute circuit described; parts at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
2026-11-13 Power section: parts selected (design note v0.4)
    All power parts chosen at JLCPCB and listed in section 10 of the note:
    modules VRA1215YMD-6WR3 and K7805-2000R3, MC78M12 / MC79M12 regulators,
    AMS1117-3.3, SS34 bridge, SMBJ18A, resettable fuse, DC jack, bulk and
    filter capacitors, 2.2 uH filter inductors.
    Corrects an error in v0.2/v0.3: the MC79M12...DTRKG order codes are not
    discontinued (only the older codes without the final G are).
    STATUS.md: stopping point, the power schematic split into steps A-E, and
    the JLCPCB search method that works.
2026-11-13 Power section step B: input protection and 5 V module
    power-input.kicad_sch: DC jack J9, resettable fuse F1, Schottky bridge
    D9-D12 (either plug polarity), TVS D14, VIN_SENSE node for the mute
    circuit, series diode D13, 470 uF bulk capacitor, K7805-2000R3 module PS1
    with 22 uF ceramics, +5 V and GND with power flags.
    Netlist matches the intended circuit. ERC: 4 expected findings
    (BYPASS_RELAY waits for the Daisy sheet; +12 V, -12 V and GNDA get their
    source in the next step). The DC jack pin assignment is to be confirmed on
    its datasheet before the PCB (recorded in STATUS.md).
    [input-gain.kicad_sch, input-inst.kicad_sch, input-jacks.kicad_sch, input.kicad_sch, main-board.kicad_sch, output-dac.kicad_sch, output-jacks.kicad_sch, output-pots.kicad_sch]
2026-11-13 STATUS and power note: step B done, next is step C
2026-11-13 Power section step C: +/-15 V module, filters, +/-12 V regulators
    power-analog.kicad_sch: VRA1215YMD-6WR3 (PS2) fed from VIN_DC, 100 uF +
    2.2 uH + 100 uF filter on each output (inside the module's 220 uF limit),
    MC78M12 and MC79M12 with 10 uF + 100 nF at the outputs, reverse diodes
    D15/D16, power flags. The isolated output common is the analog ground GNDA.
    Datasheets: MC78M12 gives 11.4-12.6 V for 14.5 V input or more (onsemi
    MC78M00/D); DC jack pin-out confirmed on the HRO drawing.
    Netlist matches the intended circuit. ERC: 1 expected finding
    (BYPASS_RELAY waits for the Daisy sheet); every supply rail has a source.
    [main-board.kicad_sch, power-analog.kicad_sch]
2026-11-13 CLAUDE.md: session routine (start from STATUS, update after every step, /clear)
    The repository is the memory: each session starts from CLAUDE.md and
    docs/STATUS.md and reads only what the next step needs. After every
    completed step STATUS.md is updated (and requirements plus the design note
    when a decision changed), commit and push are proposed, and Antonios is
    reminded to /clear and restart with "Διάβασε το STATUS και συνέχισε".
